Mitokongdrya/SAMI_Presentation/docs/README.md

# Social Animated Mechanical Interlocutor (SAMI) Robot Overview and Documentation
The Social Animated Mechanical Interlocutor (SAMI) robot is made up of several pieces. The physical robot itself, a high-level controlling computer or microcontroller, and the sensor and interaction interface box.

## What is SAMI?

## High Level System Capabilities
