Mitokongdrya/SAMI_Presentation/docs/res/Chest_Back.jpeg

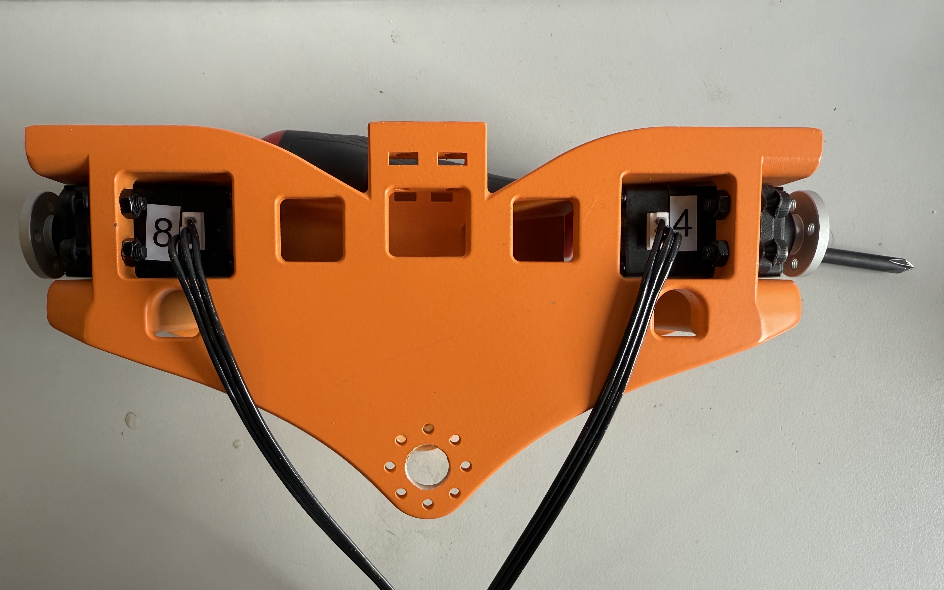
docs/res/Chest_Back.jpeg
