Mitokongdrya/SAMI_Presentation/docs/res/ChestConnector_Angled2.jpeg

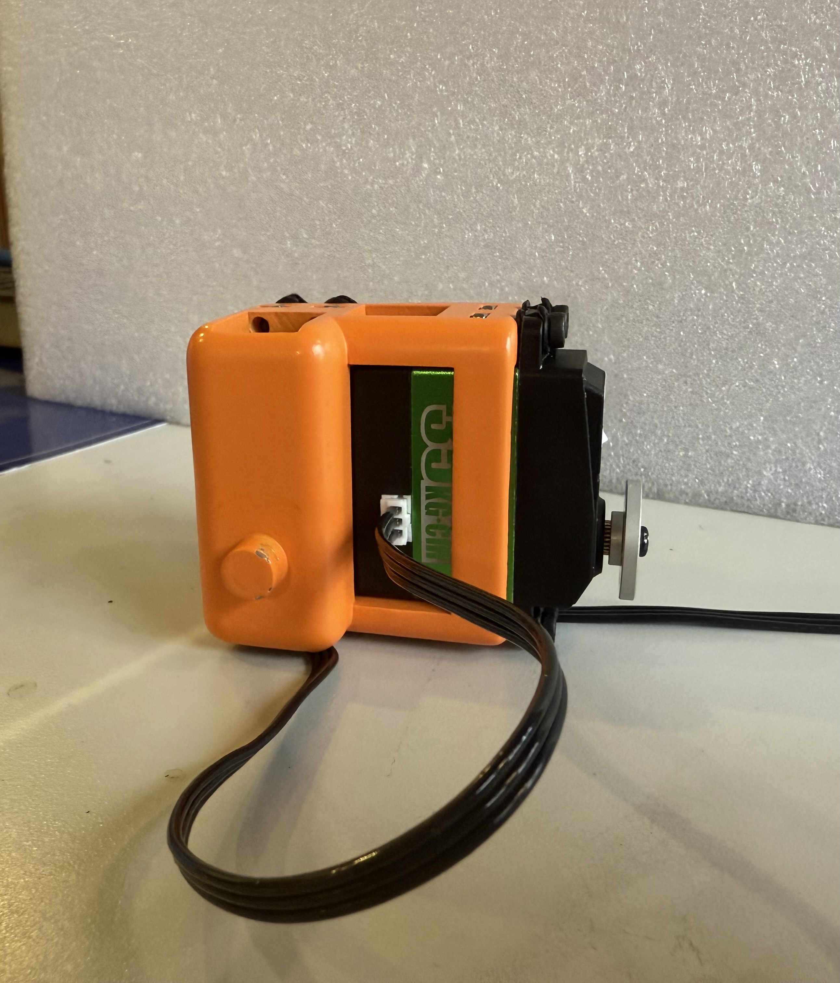
docs/res/ChestConnector_Angled2.jpeg
