Mitokongdrya/SAMI_Presentation/docs/res/ChestConnector_Angled.jpeg

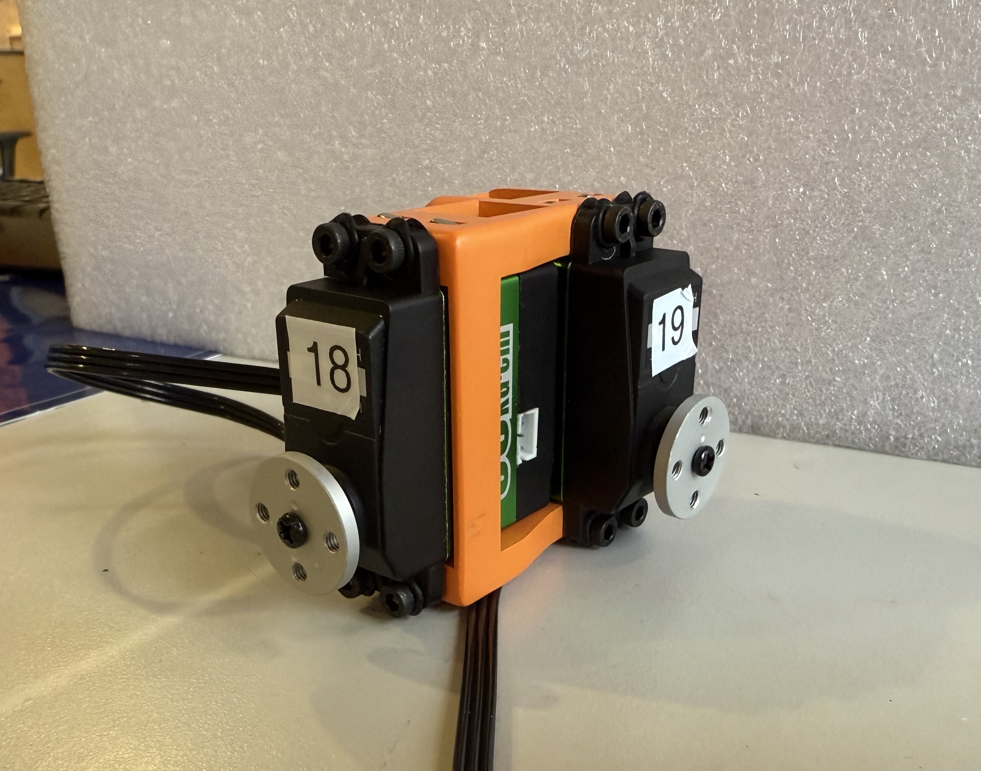
docs/res/ChestConnector_Angled.jpeg
