Mitokongdrya/SAMI_Presentation/docs/res/ChestConnector_Bottom.jpeg

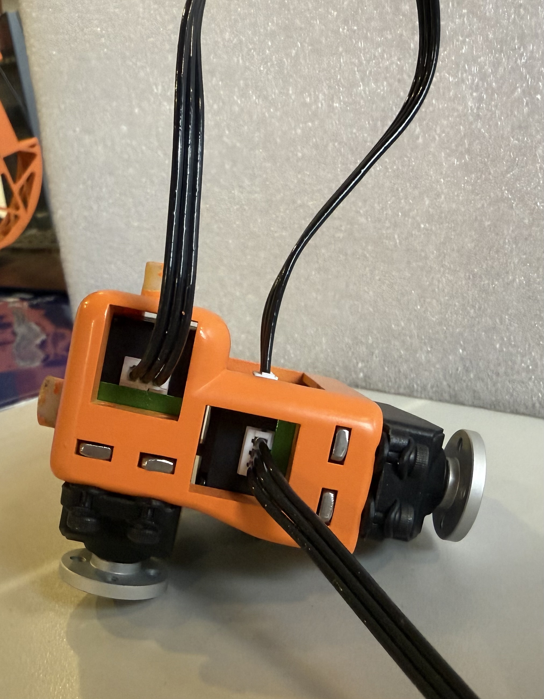
docs/res/ChestConnector_Bottom.jpeg
