Mitokongdrya/SAMI_Presentation/docs/res/Control_Board.jpeg

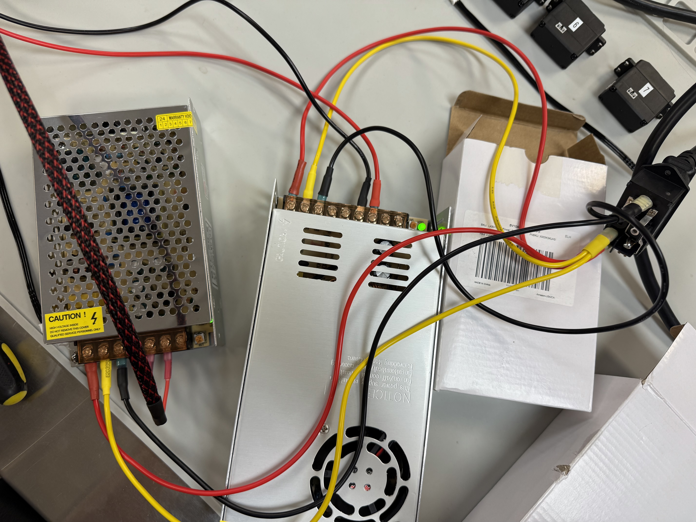
docs/res/Control_Board.jpeg
