Mitokongdrya/SAMI_Presentation/docs/res/LeftFoot_Angled.jpeg

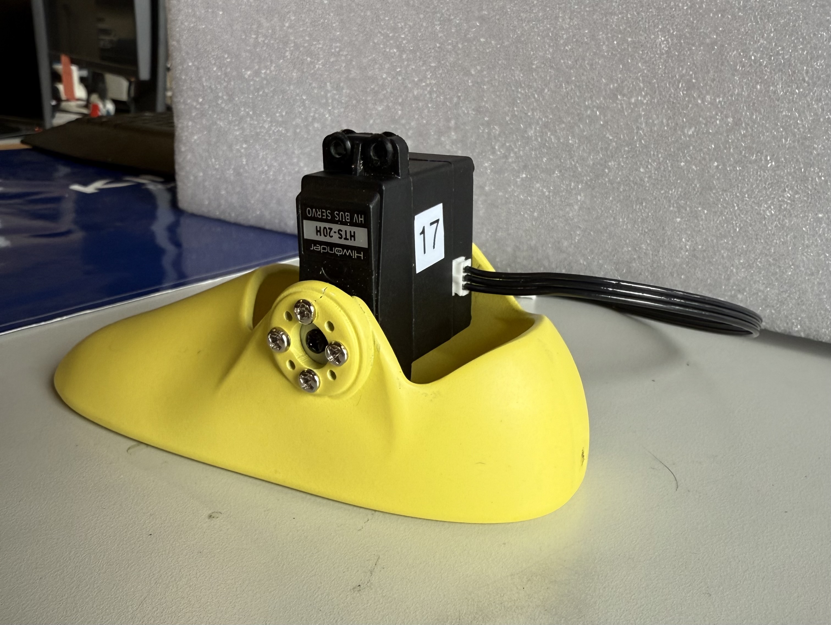
docs/res/LeftFoot_Angled.jpeg
