Mitokongdrya/SAMI_Presentation/docs/res/LeftFoot_Front.jpeg

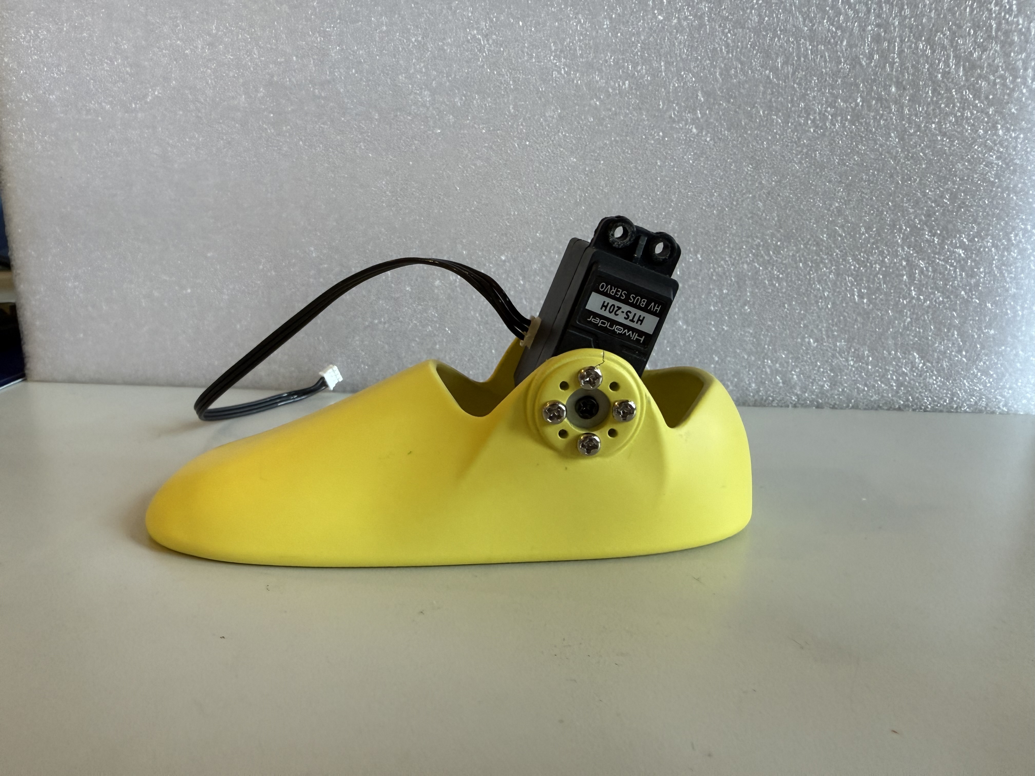
docs/res/LeftFoot_Front.jpeg
