Mitokongdrya/SAMI_Presentation/docs/res/leg_extensions.jpg

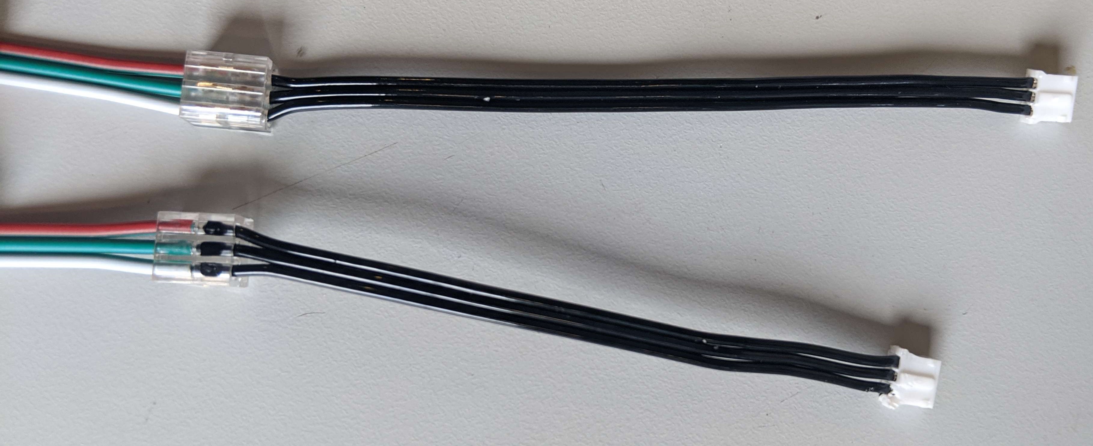
docs/res/leg_extensions.jpg
