Mitokongdrya/SAMI_Presentation/docs/res/long_eyes_conn.jpg

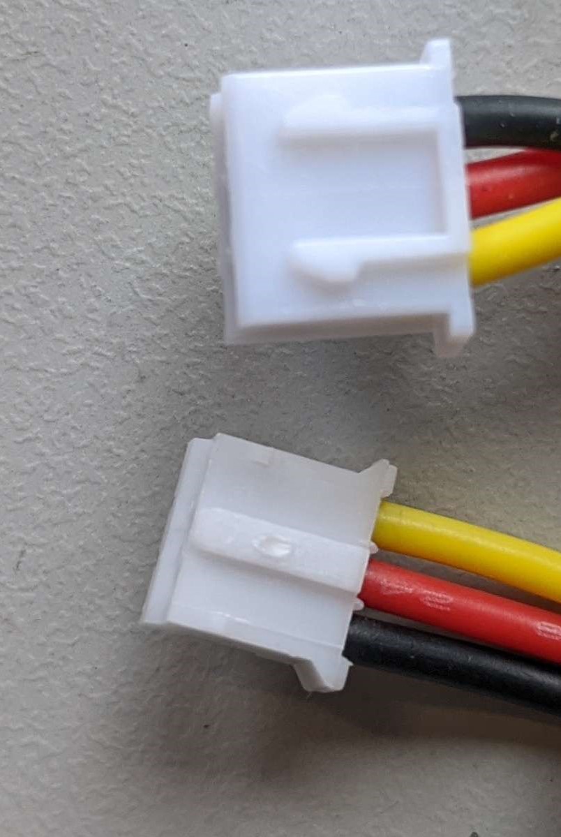
docs/res/long_eyes_conn.jpg
