Mitokongdrya/SAMI_Presentation/docs/res/Neck_Back.jpeg

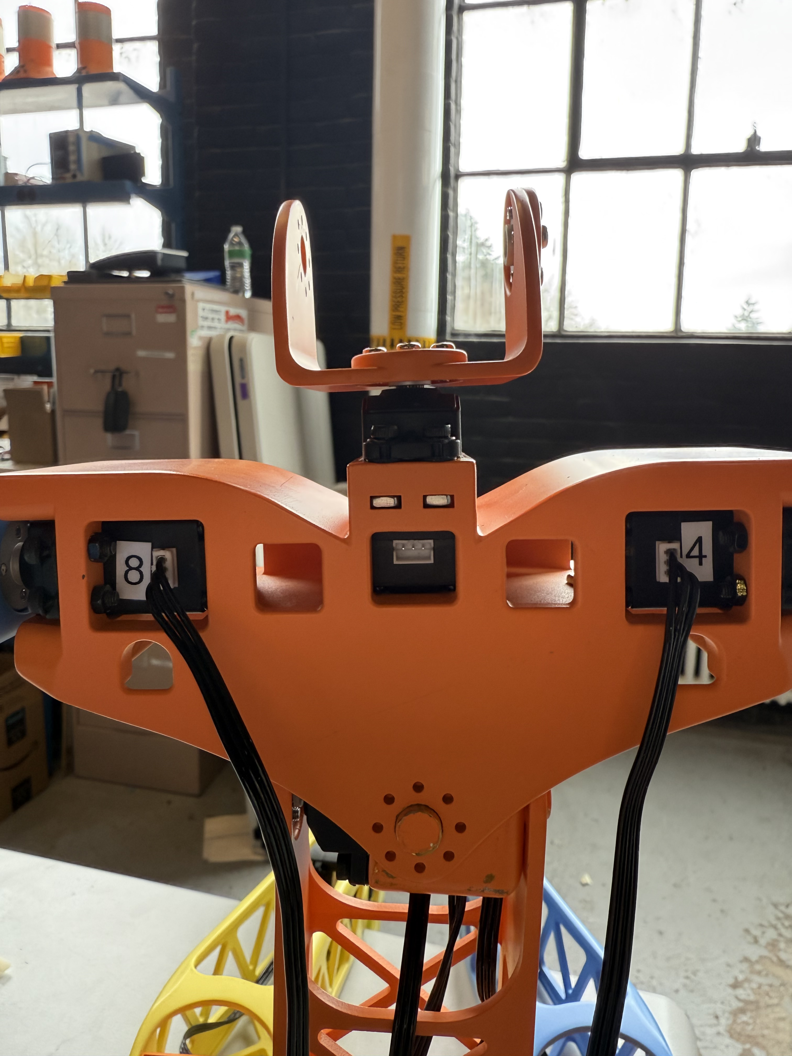
docs/res/Neck_Back.jpeg
