Mitokongdrya/SAMI_Presentation/docs/res/NeckConnector_Angled.jpeg

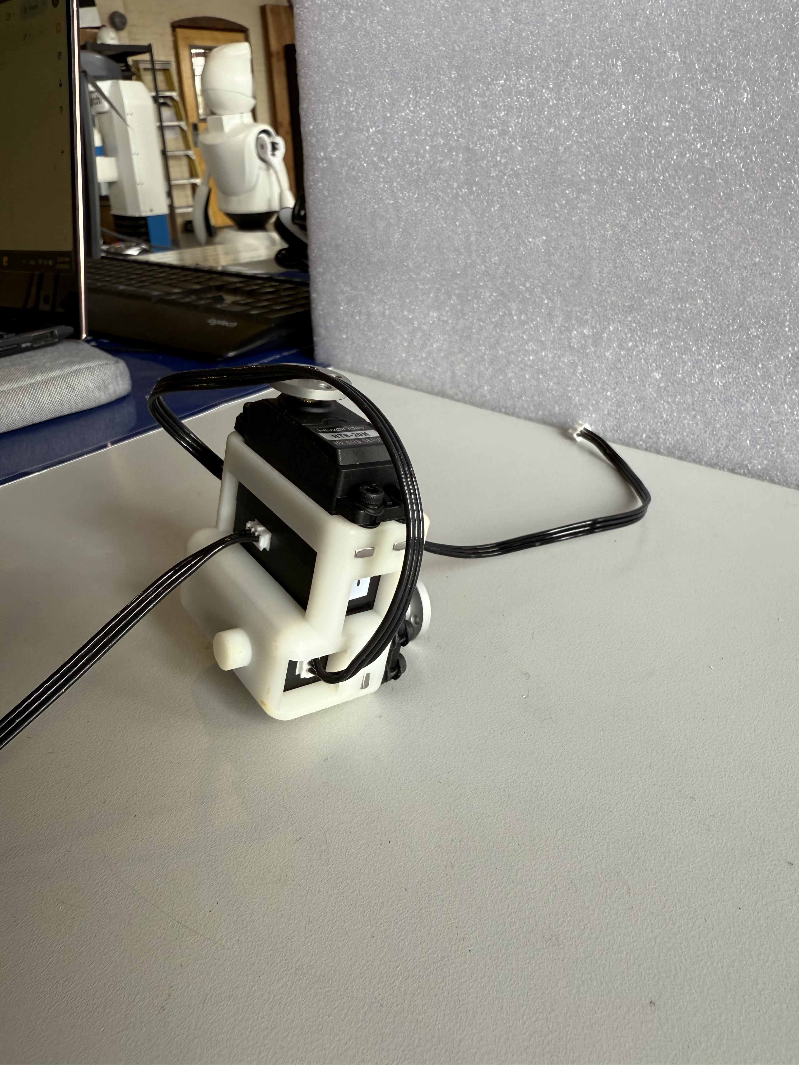
docs/res/NeckConnector_Angled.jpeg
