Mitokongdrya/SAMI_Presentation/docs/res/NeckConnector_Side.jpeg

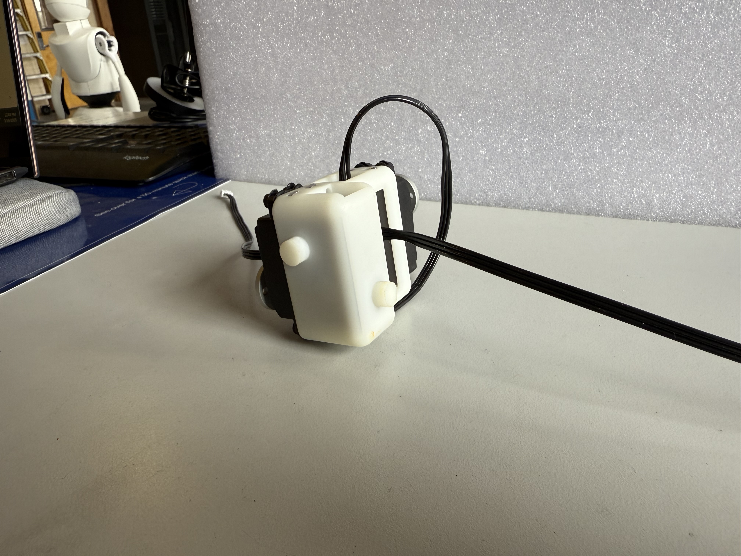
docs/res/NeckConnector_Side.jpeg
