Mitokongdrya/SAMI_Presentation/docs/res/NeckConnector_Top.jpeg

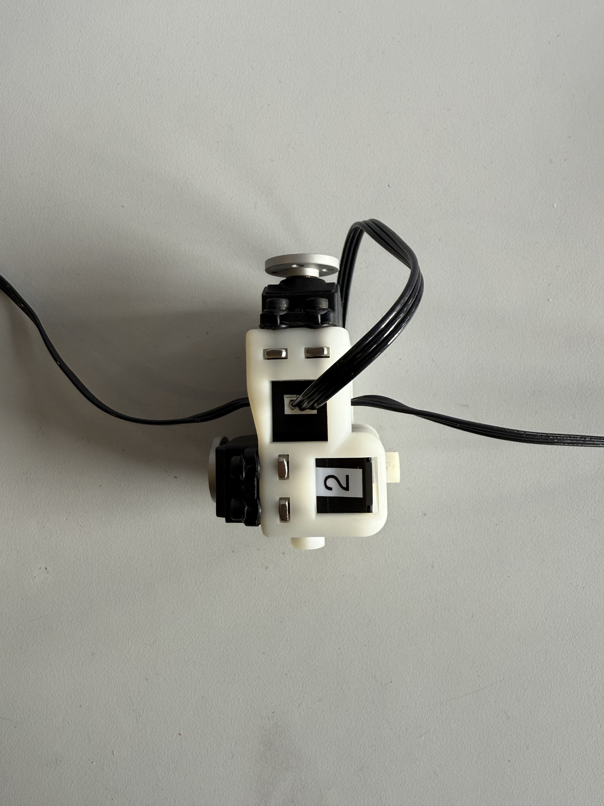
docs/res/NeckConnector_Top.jpeg
