Mitokongdrya/SAMI_Presentation/docs/res/RightLeg_Back.jpeg

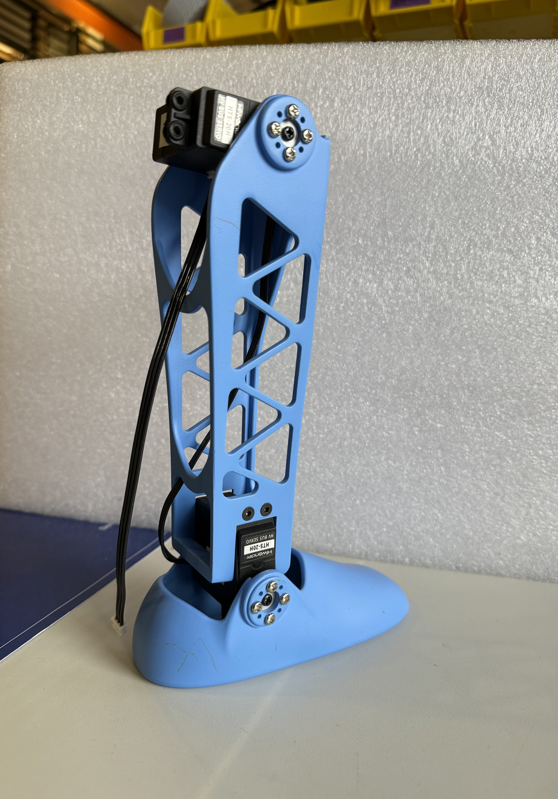
docs/res/RightLeg_Back.jpeg
