Mitokongdrya/SAMI_Presentation/docs/res/short_eyes_conn.jpg

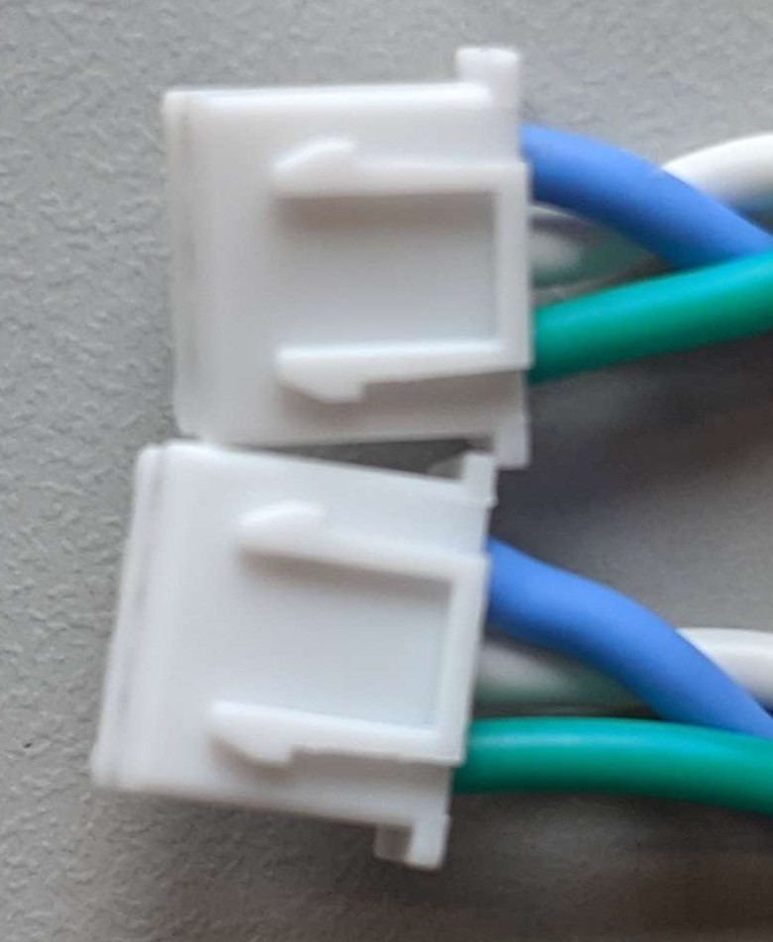
docs/res/short_eyes_conn.jpg
