Mitokongdrya/SAMI_Presentation/docs/res/Shoulder_Bicep_Front.jpeg

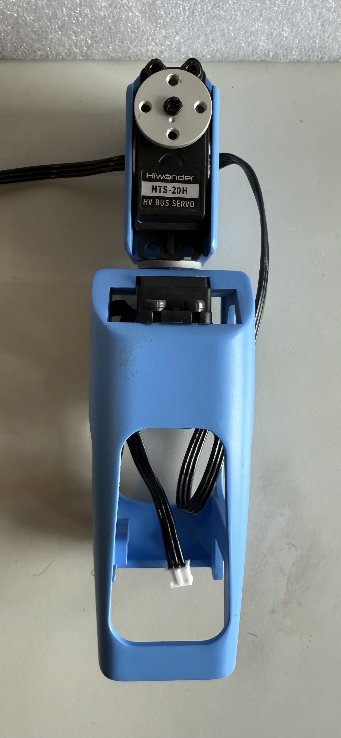
docs/res/Shoulder_Bicep_Front.jpeg
