Mitokongdrya/SAMI_Presentation/docs/res/Shoulder_Bicep_Side.jpeg

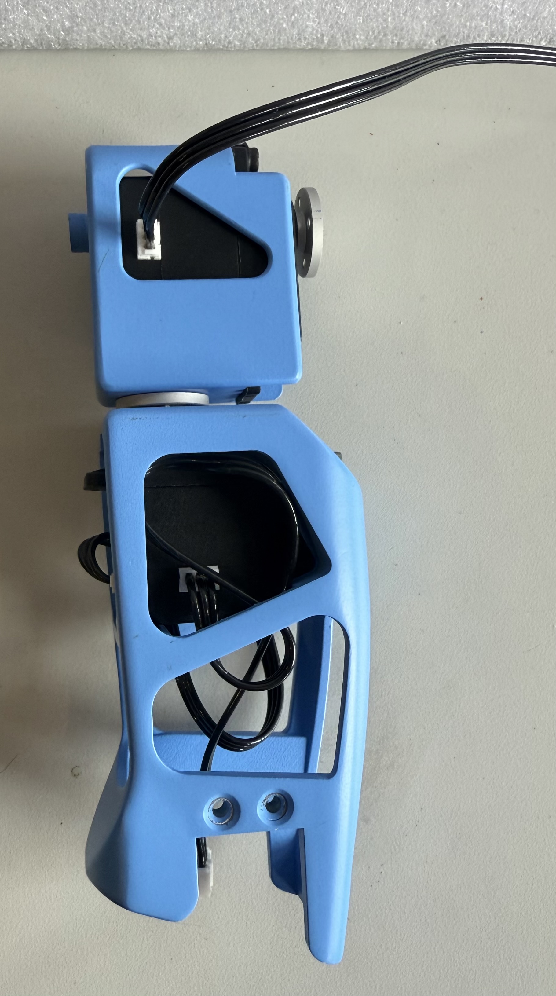
docs/res/Shoulder_Bicep_Side.jpeg
