Mitokongdrya/SAMI_Presentation/hardware/Electrical/res/ArmCurrentRatings.png

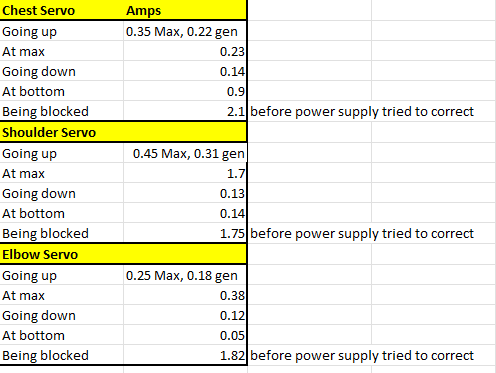
hardware/Electrical/res/ArmCurrentRatings.png
