Mitokongdrya/SAMI_Presentation/hardware/Electrical/res/LegCurrentRatings.png

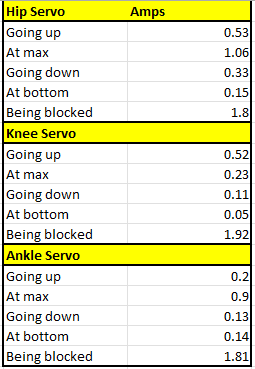
hardware/Electrical/res/LegCurrentRatings.png
