Mitokongdrya/SAMI_Presentation/hardware/SAMIPartList.xlsx

Sheet: Mechanical + Motors
 |  |  | Single Motor |  |  |  |  | Left and Right Side Motor
Part | Quantity | Notes | Head Twist | Head Nod | Head Tilt | Torso Tilt | Torso Bow | Shoulder Pitch | Shoulder Roll | Arm Twist | Elbow | Gripper | Hip | Knee | Ankle | LED Eye | Camera pan
M3x14 countersunk | 4 |  |  |  |  |  |  |  |  |  |  |  |  |  | 2
M3x16 countersunk | 4 |  |  |  |  |  |  |  |  |  | 2
M3x16 | 12 |  |  |  |  |  |  | 4 |  |  |  |  | 2
M3x18 countersunk | 4 |  |  |  |  |  |  |  |  |  |  |  |  | 2
M3x18 | 10 |  | 2 | 2 | 2 | 2 | 2
M3x30 | 4 |  |  |  |  |  |  |  |  | 2
M3x35 | 4 |  |  |  |  |  |  |  | 2
M3x40 | 4 |  |  |  |  |  |  |  |  | 2
M3 hex nut | 28 |  |  |  |  |  |  | 4 | 2 | 2 | 2 |  |  | 2 | 2
M3 square nut | 18 | Fits the 2.6mm x 5.5mm x 5.5mm square nuts | 2 | 2 | 2 | 2 | 2 |  |  | 2 |  |  | 2
M2x6 self-tapping pan head w/ washer | 20 | We could probably use these anywhere we use the M1.6 screws, but we do need them for the ankle | 2 | 2 | 2 |  |  |  |  |  |  |  | 4 |  | 3
M2x8 self-tapping pan head w/ washer | 8 | Specifically for the arm twist, and if we do all self-tapping, we'd use these for the shoulder pitch too |  |  |  |  |  |  |  | 4
M1.6x6 | 36 |  |  |  |  | 4 | 4 |  | 4 |  | 4 |  |  | 4 |  | 2
M1.6x8 | 8 | motor horn |  |  |  |  |  | 4
M1.6 hex nut | 52 | motor horn |  |  |  | 4 | 4 | 4 | 4 |  | 4 |  |  | 4 | 4 | 2
M1.6 flat washer | 52 | motor horn |  |  |  | 4 | 4 | 4 | 4 |  | 4 |  |  | 4 | 4 | 2
HTS-20H | 18 | main servo motor, using the towerpro dimensions | 1 | 1 | 1 |  |  | 1 | 1 | 1 | 1 |  | 1 | 1 | 1 |  | 1
HTS-35H | 2 | Hiwonder servo motor dimensions |  |  |  | 1 | 1
Actuonix PQ12-R-63 | 2 |  |  |  |  |  |  |  |  |  |  | 1

Sheet: Electrical - Non Digikey
Link | Part | Quantity | Type | Notes
 | Microcontroller | 1 | microcontroller | Currently we can run either 3v or 5v logic for the microcontroller, but we require one that has at least 2 uarts and 2 pwm pins
 |  | 1 |  | 12VDC 70A power supply
 |  | 1 |  | 5VDC 4A power supply
 | XT60PW-M | 1 | connector | pcb side power connector
 | XT60P-F | 1 | connector | Power supply connector to pcb

Sheet: DigiKey Robot PartList
Country of Origin may be different at time of shipment.
The HTSUS and ECCN information shown is for informational purposes only and is not a representation or warranty as to the accuracy or reliability of these classifications. All information is provided "as is" and is subject to change without notice. Any use made of the information provided is without recourse to Digi-Key and at the user's risk.
Index | Manufacturer Part Number | Manufacturer Name | Description | Availability | Stock Status | Attrition % | Requested Quantity 1 | Pack Quantity 1 | Pack Type 1 | Digi-Key Part Number 1 | Unit Price 1 | Extended Price 1 | Minimum Order Quantity 1 | Customer Reference | Requested Part Number | Lead Weeks | Datasheet | Reference Designator | US Import Tariff | Note | Part Status | RoHS Status | Moisture Sensitivity Level (MSL) | ECCN | HTSUS | Country of Origin | Environmental Information | Original Part numbers | Image | Product Notes
1 | 1487 | Adafruit Industries LLC | ADDRESS LED MATRIX SERIAL RGB | 27 | In Stock |  | 2 | 2 | Bulk | 1528-1094-ND | 34.95000 | $69.90 | 1 |  | 1528-1094-ND | 6 | https://mm.digikey.com/Volume0/opasdata/d220001/medias/docus/5389/1487_Web.pdf |  | N/A |  | Active | ROHS3 Compliant | 1 (Unlimited) | EAR99 | 8541.41.0000 | United States |  | 1528-1094-ND | https://mm.digikey.com/Volume0/opasdata/d220001/medias/images/2115/1487.JPG
2 | 4301.1405 | SCHURTER Inc. | FUSE DRWR FOR PWR MOD F'GRIP 1PL | 2,346 | In Stock |  | 1 | 1 | Bulk | 486-1956-ND | 3.26000 | $3.26 | 1 |  | 486-1956-ND | 10 | https://www.schurter.com/en/datasheet/typ_Fusedrawer_2.pdf |  | N/A |  | Active | ROHS3 Compliant | Not Applicable | EAR99 | 8538.90.8180 | Czech Republic | https://dam.schurter.com/m/02936985612c49ed/original/Declaration-of-RoHS-Conformance.pdf|https://us.schurter.com/content/download/5693416/86091318/file/REACH%20EN%202021_10_27.pdf | 486-1956-ND | https://mm.digikey.com/Volume0/opasdata/d220001/medias/images/524/4301.1405.JPG
3 | DD11.0113.1110 | SCHURTER Inc. | PWR ENT MOD RCPT IEC320-C14 PNL | 1,155 | In Stock |  | 1 | 1 | Box | 486-1277-ND | 10.71000 | $10.71 | 1 |  | 486-1277-ND | 9 | https://us.schurter.com/en/datasheet/typ_DD11.pdf |  | N/A |  | Active | ROHS3 Compliant | Not Applicable | EAR99 | 8536.69.4030 | Czech Republic | https://dam.schurter.com/m/02936985612c49ed/original/Declaration-of-RoHS-Conformance.pdf|https://us.schurter.com/content/download/5693416/86091318/file/REACH%20EN%202021_10_27.pdf | 486-1277-ND | https://mm.digikey.com/Volume0/opasdata/d220001/medias/images/414/DD11.0113.1110.JPG
4 | BK/GMA-6-R | Eaton - Electronics Division | FUSE GLASS 6A 125VAC 5X20MM | 2,595 | In Stock |  | 1 | 1 | Bulk | 283-2885-ND | 0.69000 | $0.69 | 1 |  | 283-2885-ND | 13 | https://www.eaton.com/content/dam/eaton/products/electronic-components/resources/data-sheet/eaton-gma-time-delay-glass-tube-fuses-data-sheet.pdf |  | May apply on shipments to the U.S. |  | Active | ROHS3 Compliant | 1 (Unlimited) | EAR99 | 8536.10.0020 | China |  | 283-2885-ND | https://mm.digikey.com/Volume0/opasdata/d220001/medias/images/1063/CooperBussmann-SERIES-GMA.jpg
5 | PR24-5V-900-1A | CUI Devices | RELAY GEN PURPOSE SPST 40A 5V | 908 | In Stock |  | 3 | 3 | Tray | 2223-PR24-5V-900-1A-ND | 1.65000 | $4.95 | 1 |  | 2223-PR24-5V-900-1A-ND | 10 | https://www.cuidevices.com/product/resource/digikeypdf/pr24.pdf |  | May apply on shipments to the U.S. |  | Active | ROHS3 Compliant | Not Applicable | EAR99 | 8536.41.0050 | China |  | 2223-PR24-5V-900-1A-ND | https://mm.digikey.com/Volume0/opasdata/d220001/medias/images/4502/MFG_PR24-5V-900-1A.jpg
6 | 40SQ045 | ANBON SEMICONDUCTOR (INT'L) LIMITED | 40A AXIAL LEADED SCHOTTKY DIODES | 206 | In Stock |  | 3 | 3 | Cut Tape (CT) | 4530-40SQ045CT-ND | 1.29000 | $3.87 | 1 |  | 4530-40SQ045CT-ND | 4 | https://mm.digikey.com/Volume0/opasdata/d220001/medias/docus/4890/40SQ045.pdf |  | N/A |  | Active | ROHS3 Compliant | 1 (Unlimited) | EAR99 | 8541.10.0080 | China |  | 4530-40SQ045CT-ND | https://mm.digikey.com/Volume0/opasdata/d220001/medias/images/4887/MFG_40SQ045.jpg
7 | 1N4732A | onsemi | DIODE ZENER 4.7V 1W DO41 | 10,195 | In Stock |  | 3 | 3 | Bulk | 1N4732AFS-ND | 0.24000 | $0.72 | 1 |  | 1N4732AFS-ND | 32 | https://rocelec.widen.net/view/pdf/7qfz7dzkx8/ONSM-S-A0003585147-1.pdf?t.download=true&u=5oefqw |  | May apply on shipments to the U.S. |  | Active | ROHS3 Compliant | Not Applicable | EAR99 | 8541.10.0050 | China | https://www.onsemi.com/site/pdf/RoHS-statement.pdf|https://www.onsemi.com/PowerSolutions/MaterialComposition.do?export=pdf&opnId=1N4732A | 1N4732AFS-ND | https://mm.digikey.com/Volume0/opasdata/d220001/medias/images/1177/DO-204AL.jpg
8 | 1N4001-G | Comchip Technology | DIODE GEN PURP 50V 1A DO41 | 38,214 | In Stock |  | 3 | 3 | Cut Tape (CT) | 641-1310-1-ND | 0.21000 | $0.63 | 1 |  | 641-1310-1-ND | 10 | https://www.comchiptech.com/admin/files/product/1N4001-G%20Thru.%201N4007-G%20RevB.pdf |  | N/A |  | Active | ROHS3 Compliant | 1 (Unlimited) | EAR99 | 8541.10.0080 | Taiwan | https://www.comchiptech.com/admin/files/tech/213_20201006093628.pdf | 641-1310-1-ND | https://mm.digikey.com/Volume0/opasdata/d220001/medias/images/4849/641_1N5819-G.JPG
9 | BC337-25 | Diotec Semiconductor | BJT TO-92 45V 800MA | 10,501 | In Stock |  | 3 | 3 | Cut Tape (CT) | 4878-BC337-25CT-ND | 0.18000 | $0.54 | 1 |  | 4878-BC337-25CT-ND | 2 | https://diotec.com/request/datasheet/bc337.pdf |  | May apply on shipments to the U.S. |  | Active | Not applicable | Not Applicable | EAR99 | 8541.21.0075 | China | https://diotec.com/request/imds/p210_e.pdf | 4878-BC337-25CT-ND | https://mm.digikey.com/Volume0/opasdata/d220001/medias/images/3602/MFG_BC327-16.jpg
10 | R-78E5.0-1.0 | Recom Power | DC DC CONVERTER 5V 5W | 1,854 | In Stock |  | 2 | 2 | Tube | 945-2201-ND | 3.92000 | $7.84 | 1 |  | 945-2201-ND | 4 | https://recom-power.com/pdf/Innoline/R-78E-1.0.pdf |  | May apply on shipments to the U.S. |  | Active | ROHS3 Compliant | 1 (Unlimited) | EAR99 | 8542.39.0060 | Taiwan | https://recom-power.com/en/support/certifications/rohs/rohs.html?0 | 945-2201-ND | https://mm.digikey.com/Volume0/opasdata/d220001/derivates/6/002/665/033/MFG_R-78-e%20series_web%28640x640%29.jpg
11 | EY1C102MP51016EU | Chinsan (Elite) | CAP ALUM 1000UF 20% 16V RADIAL | 280 | In Stock |  | 1 | 1 | Cut Tape (CT) | 4191-EY1C102MP51016EUCT-ND | 0.33000 | $0.33 | 1 |  | 4191-EY1C102MP51016EUCT-ND | 18 | https://mm.digikey.com/Volume0/opasdata/d220001/medias/docus/2526/EY%20Series.pdf |  | N/A |  | Active | ROHS3 Compliant | 1 (Unlimited) | EAR99 | 8532.22.0020 | China |  | 4191-EY1C102MP51016EUCT-ND | https://mm.digikey.com/Volume0/opasdata/d220001/medias/images/4520/MFG_Radial-lead-type-brown.jpg | Non Cancellable Non Returnable.
12 | SN74HC126N | Texas Instruments | IC BUFFER NON-INVERT 6V 14DIP | 2,195 | In Stock |  | 1 | 1 | Tube | 296-8221-5-ND | 0.69000 | $0.69 | 1 |  | 296-8221-5-ND | 12 | https://www.ti.com/lit/ds/symlink/sn74hc126.pdf |  | N/A |  | Active | ROHS3 Compliant | Not Applicable | EAR99 | 8542.39.0060 | Malaysia |  | 296-8221-5-ND | https://mm.digikey.com/Volume0/opasdata/d220001/medias/images/3623/Mfg_296%7E4040049%7EN%7E14.jpg
13 | LR1F1K0 | TE Connectivity Passive Product | RES 1K OHM 1% 0.6W AXIAL | 579,931 | In Stock |  | 2 | 2 | Cut Tape (CT) | A105951CT-ND | 0.10000 | $0.20 | 1 |  | A105951CT-ND | 14 | https://www.te.com/usa-en/product-1622349-1.datasheet.pdf |  | N/A |  | Active | ROHS3 Compliant | Not Applicable | EAR99 | 8533.21.0090 | Thailand | http://www.te.com/commerce/alt/SinglePartSearch.do?PN=1622349-1&dest=stmt | A105951CT-ND | https://mm.digikey.com/Volume0/opasdata/d220001/medias/images/2609/LR%20Neohm%201k.jpg
14 | LR1F10K | TE Connectivity Passive Product | RES 10K OHM 1% 0.6W AXIAL | 803,334 | In Stock |  | 1 | 1 | Cut Tape (CT) | A105947CT-ND | 0.10000 | $0.10 | 1 |  | A105947CT-ND | 14 | https://www.te.com/usa-en/product-1622298-1.datasheet.pdf |  | N/A |  | Active | ROHS3 Compliant | Not Applicable | EAR99 | 8533.21.0090 | Thailand | http://www.te.com/commerce/alt/SinglePartSearch.do?PN=1622298-1&dest=stmt | A105947CT-ND | https://mm.digikey.com/Volume0/opasdata/d220001/medias/images/2584/LR%20Neohm%2010k.jpg
15 | 2N3904 | Diotec Semiconductor | BJT TO-92 40V 200MA | 1,944 | In Stock |  | 1 | 1 | Cut Tape (CT) | 4878-2N3904CT-ND | 0.13000 | $0.13 | 1 |  | 4878-2N3904CT-ND | 2 | https://diotec.com/request/datasheet/2n3904.pdf |  | May apply on shipments to the U.S. |  | Active | Not applicable | Not Applicable | EAR99 | 8541.21.0075 | China | https://diotec.com/request/imds/p210_e.pdf | 4878-2N3904CT-ND | https://mm.digikey.com/Volume0/opasdata/d220001/medias/images/3602/MFG_BC327-16.jpg
16 | FG26X7R1E106KRT06 | TDK Corporation | CAP CER 10UF 25V X7R RADIAL | 14,216 | In Stock |  | 4 | 4 | Cut Tape (CT) | 445-173437-1-ND | 0.68000 | $2.72 | 1 |  | 445-173437-1-ND | 24 | https://product.tdk.com/en/system/files |  | May apply on shipments to the U.S. |  | Active | ROHS3 Compliant | Not Applicable | EAR99 | 8532.24.0060 | China | https://product.tdk.com/en/environment/index.html | 445-173437-1-ND | https://mm.digikey.com/Volume0/opasdata/d220001/medias/images/21/MFG_FG26.JPG
