Mitokongdrya/SAMI_Presentation/hardware/Electrical/SensorArduinoHat/CD74HC14E/N0014A.stp

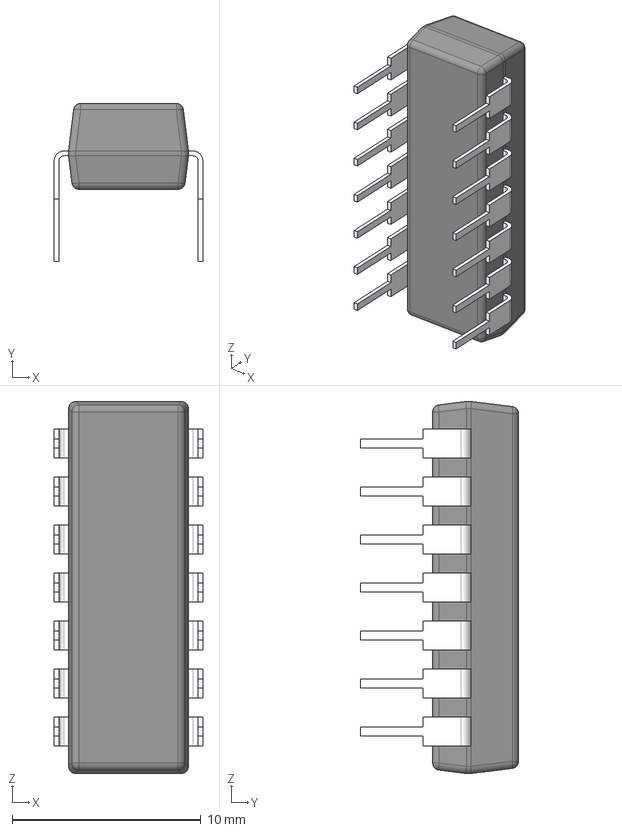
[picture p27: CAD file, 2026-03-08]
hardware/Electrical/SensorArduinoHat/CD74HC14E/N0014A.stp
7.87 x 8.37 x 19.7 mm
BODY_N0014A_AF0
LEAD_N0014A_AF1
LEAD_N0014A x 10
LEAD_N0014A_AF3
LEAD_N0014A_AF0
LEAD_N0014A_AF2
