Mitokongdrya/SAMI_Presentation/docs/component-fabrication.md

---
layout: default
id: part-fabrication
title: Sub-Assembly Fabrication for the Robot
sidebar_label: Part Fabrication
previous_page: assembly-intro
next_page: assembly-control
---
# Sub-Assembly Fabrication for the Robot

## 3D Printing & Orientations
*If using Prusa i3 printers with Prusa Slicer,* all parts should be printed at 0.3mm resolution ("draft quality" on Prusa Slicer), with 15% gyroid infill, and organic supports enabled (where necessary), **except for the chest piece,** which should be printed at 0.2mm resolution, with 15% gyroid infill, and normal grid-style supports instead. Alternatively, the **finger hinges** should be printed using TPU filament with 0% gyroid infill and a brim.

**The hands** used for this robot have been sized down by 42.5% with minimal changes to the bolt holes from the [original prosthetic model](), but the mechanism funtionality remains the same.

Print orientations are shown below for each part, along with the part names that are used throughout this documentation.

### Headshell
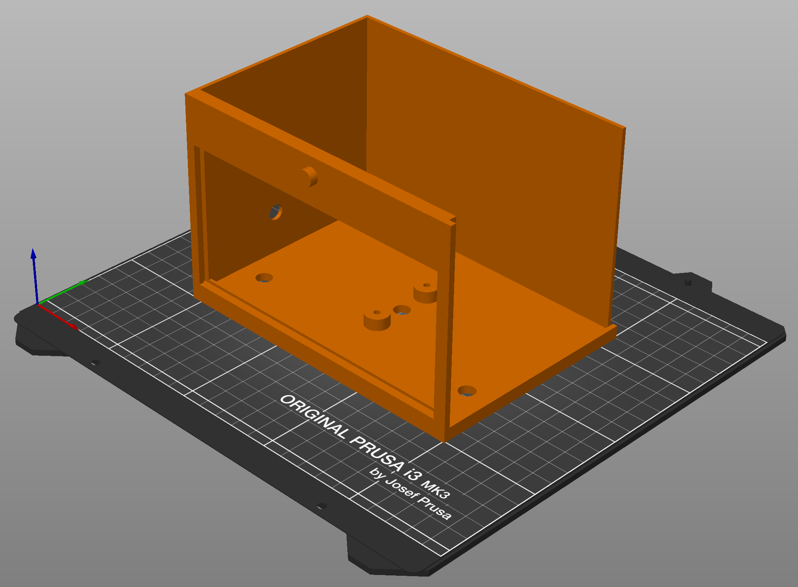
[picture p105: docs/res/Headshell.png]


### Chest and Headshell Panel
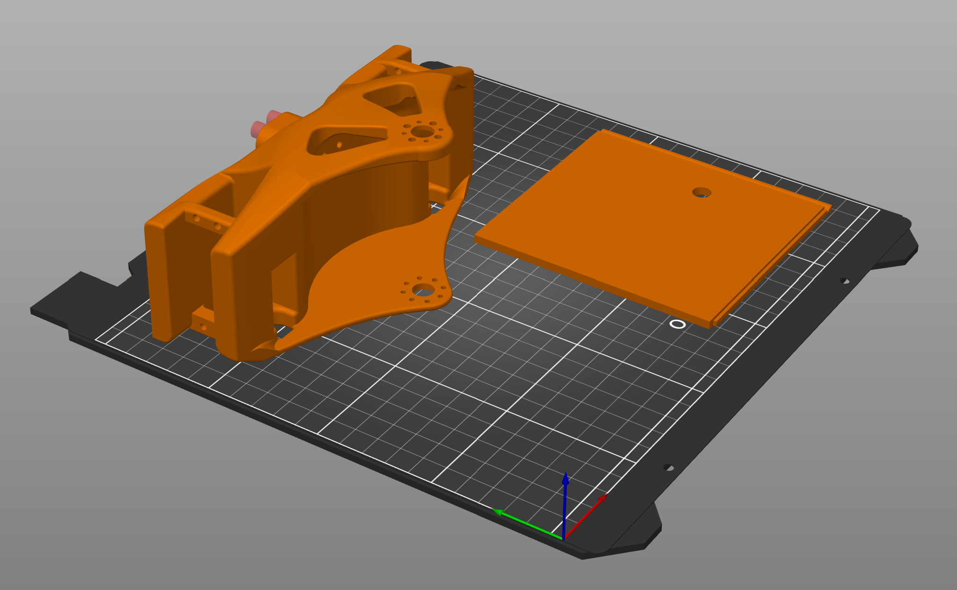
[picture p106: docs/res/Chest_HeadshellSidePanel.png]


### Head/Neck Connectors and Spine
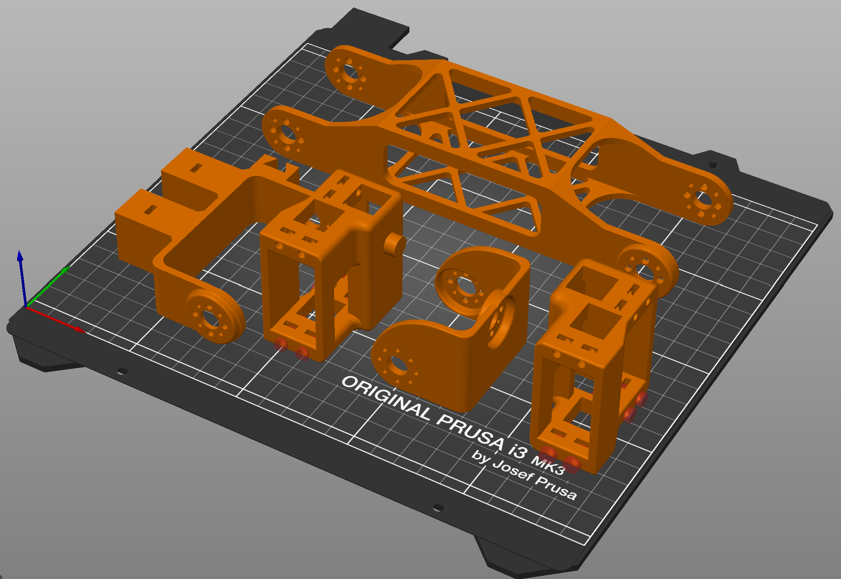
[picture p107: docs/res/HeadnNeck_Connector_Spine.png]


### Shoulders and Upper Arms
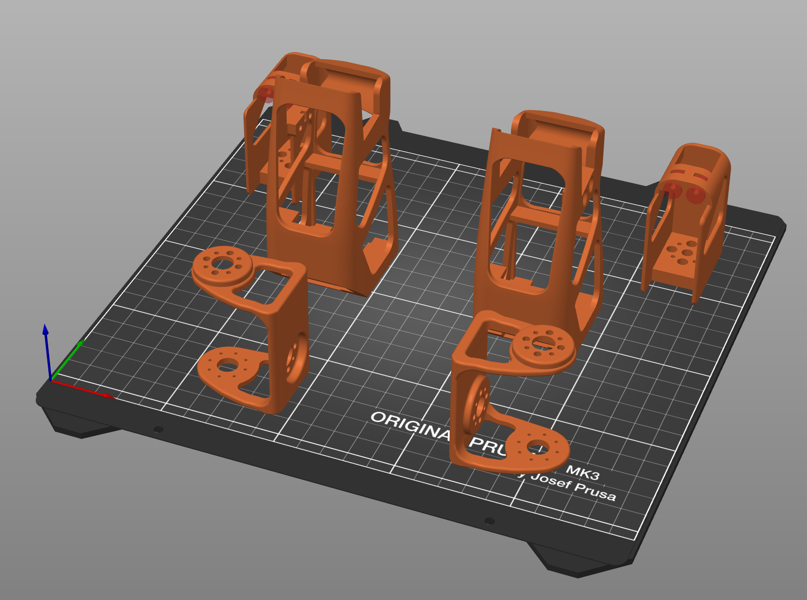
[picture p108: docs/res/Shoulders_Biceps.png]


### Hands and Lower Arms
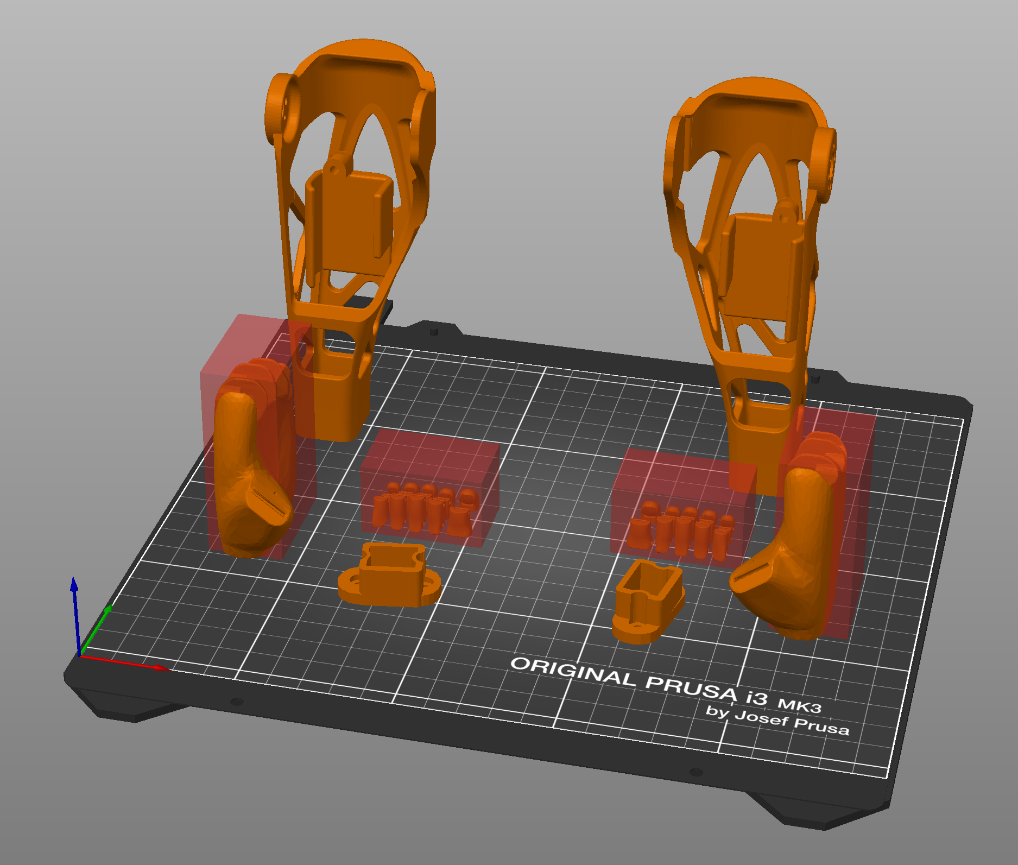
[picture p109: docs/res/Hands_Lower Arms.png]


### Finger Hinges
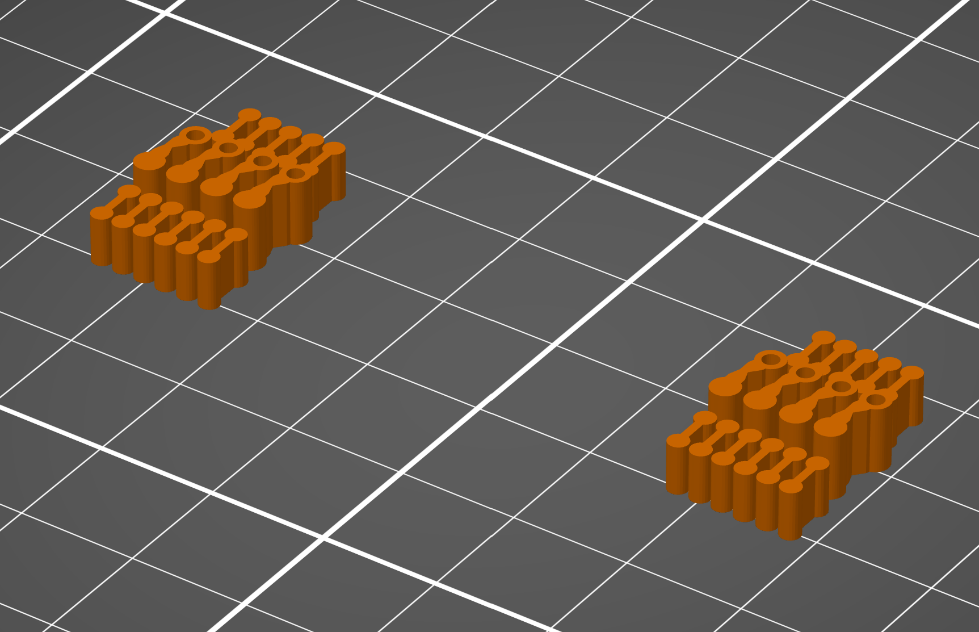
[picture p110: docs/res/FFX_Finger_Hinge_Plate.png]


### Hips and Upper Legs
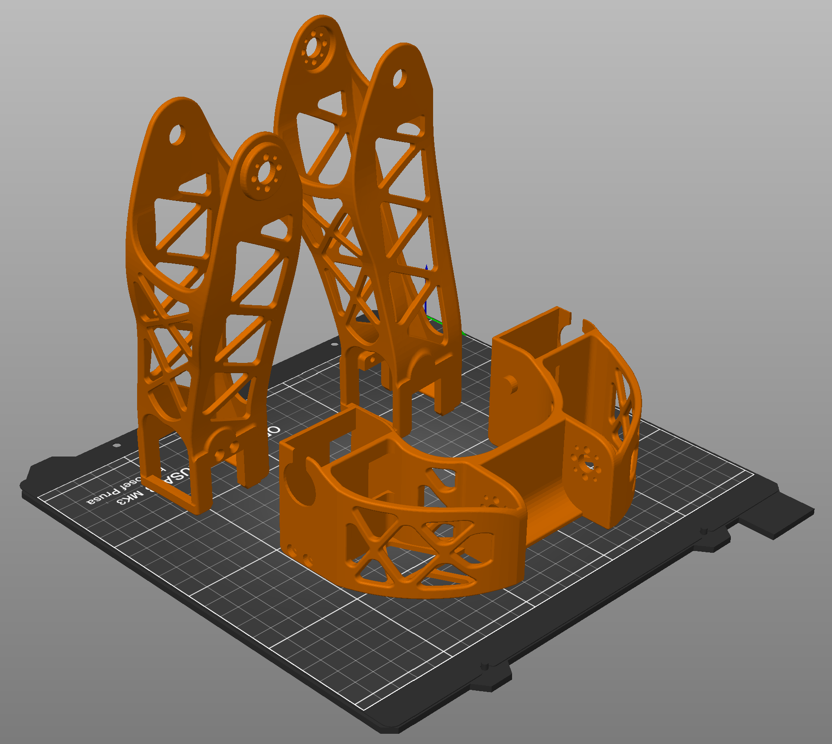
[picture p111: docs/res/Hip_UpperLegs.png]


### Lower Legs and Feet
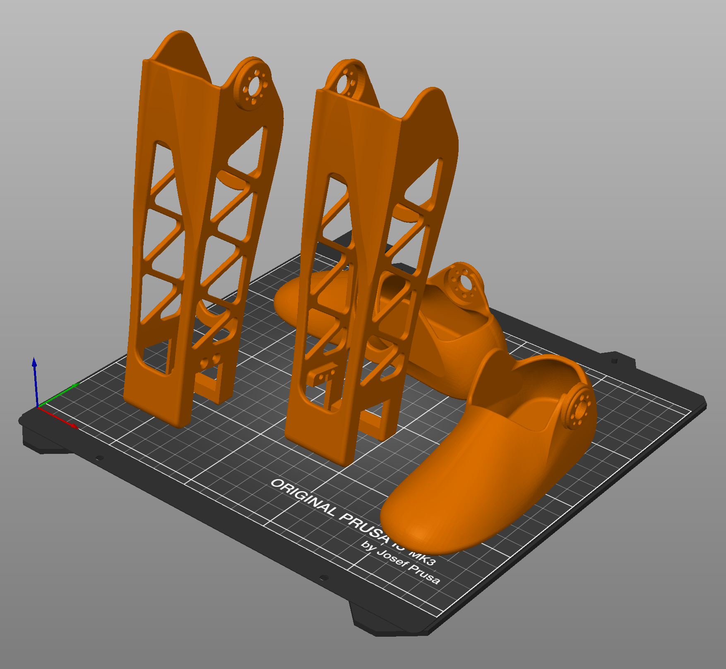
[picture p112: docs/res/LowerLegs_Feet.png]
