Mitokongdrya/SAMI_Presentation/docs/Getting-Started.md

---
layout: default
id: getting-started
title: Getting Started with the System
sidebar_label: Getting Started
next_page: assembly-intro
---
# Getting Started with the System
