Mitokongdrya/SAMI_Presentation/docs/Robot-Assembly.md

---
layout: default
id: robot-assembly
title: Robot Assembly Guide
sidebar_label: Robot Assembly
---
# Robot Assembly Guide
This section describes the part fabrication and hardware assembly process for the actual robot.
1. [3D Printing & Orientations](#3d-printing--orientations)
2. [Setting Up the Control Board](#setting-up-the-control-board)
3. [Initializing Servo IDs and Positions](#initializing-servo-ids-and-positions)
4. [Overall Assembly Information]()
5. [Neck and Torso Assembly](#neck-and-torso-assembly)
6. [Arm Assembly](#arm-assembly)
7. [Lower Body Assembly](#lower-body-assembly)
8. [Chair Assembly](#chair-modification-and-assembly)
9. [Final Assembly](#final-assembly)

The layout of the parts for the robot, with names that are used within these instructions.



## 3D Printing & Orientations
*If using Prusa i3 printers with Prusa Slicer,* all parts should be printed at 0.3mm resolution ("draft quality" on Prusa Slicer), with 15% gyroid infill, and organic supports enabled (where necessary), **except for the chest piece,** which should be printed at 0.2mm resolution, with 15% gyroid infill, and normal grid-style supports instead. Alternatively, the **finger hinges** should be printed using PETG filament with 0% gyroid infill and a brim.

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

### Headshell


### Chest and Headshell Panel


### Head/Neck Connectors and Spine


### Shoulders and Upper Arms


### Hands and Lower Arms


### Finger Hinges


### Hips and Upper Legs


### Lower Legs and Feet
   

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

   

7. Plug power cord to switch, then to a nearby power outlet.

Reference image:

   

## Initializing Servo IDs and Positions
You will need to communicate with the motors as part of the assembly process. This process can be completed using the [assembled motor control PCB](#setting-up-the-control-board), or the [HiWonder motor debugging board](https://www.hiwonder.com/products/hiwonder-ttl-usb-debugging-board).

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



To simplify assembly, the initialization steps for each motor are:

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

## Lower Body Assembly
When assembling the lower body it is best to start with the feet and then work your way up to the upper legs. This ensures that you will have everything aligned and allows you to plug to corresponding JST cables as you go.

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

Final product:




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

Reference figures:




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

Final product:



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

Final product, Left Leg:




Final product, Right Leg:

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

Final product:

   
   

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

Left Shoulder Chest

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

With both motors installed and JST cables connected, the chest from behind should look like 

   
    

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


-->

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

Chest Bow

1. Insert the black rubber spacers into all four of the screw slots on motor 19

   
**Use the connector on the right for Chest Assembly.**

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

Chest tilt

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

Attaching to the Chest

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

The figure below shows screw placement:

   
   

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

Final product: 

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

Neck Bow

1. Insert the black rubber spacers into all four of the screw slots on motor 2

   
**Use the connector on the left for Neck Assembly.**

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

Neck Tilt

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

   
   

## Arm Assembly
When assembling the arms for the robot, it is best to begin with the bicep, then shoulder, and ending with the forearms. This is due to the slight complexity behind the arm assembly. You will need to attach the motors and JST cables onto certain pieces before moving on.

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

The forearms will require one Actuonix PQ12 Micro Linear Actuator each. 

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

Bicep references with JST cables:




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

Final products (Right motor and Left motor):




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

Outcome of servo horn attachment:

   
   

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

Final product:

   
   

### Forearms
The Forearms will require:
 - a M3 hex screwdriver
 - 8x silver M3 screws

Pre-thread all screw holes before assembly.

1. Attach Forearms to respective Biceps using 4 silver M3 screws each.

Final assembly (ignore color differences, pieces were printed incorrectly):

   

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



*Figure 2*: Finger plate with labeled orientation ([Flexy-Hand 2](https://www.thingiverse.com/thing:380665))



*Figure 3*: Hinge orientation for all fingers ([Flexy-Hand 2](https://www.thingiverse.com/thing:380665))



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



*Figure 5*: Fisherman's Knot instructional image

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

   

Final product (Right Arm):

   
   

## Chair Modification and Assembly

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

Begin by first assembling the Ikea chair following their instructions.

### Power Switch

Requires:

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

### 12V Supply Mounting

Requires:

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

    

### 5V Supply Mounting

Requires:

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

### Motor Control PCB Mounting

Requires:

 - Ikea chair
 - Motor control PCB assembly
 - M3x??+6 standoffs x4
 - [PCB mounting template]()

### Robot Mounting

Requires:

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

## Final Assembly

### Eyes Assembly

Assembly of the eyes requires:

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

### Connect The Remaining Cables

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

### Flash Arduino Code

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

### Test Motor movements

Test movements for the motors using the software UI
