Mitokongdrya/SAMI_Presentation/docs/software-setup.md

---
layout: default
id: software-setup
title: Initial Software Setup and Testing
sidebar_label: Software Setup
previous_page: assembly-final
next_page: software-architecture
---
# Initial Software Setup and Testing
