Mitokongdrya/SAMI_Presentation/hardware/Electrical/JamieMotorControl/JamieMotorControl.kicad_pcb

## KiCad design hardware/Electrical/JamieMotorControl/JamieMotorControl.kicad_pcb (2026-03-08)

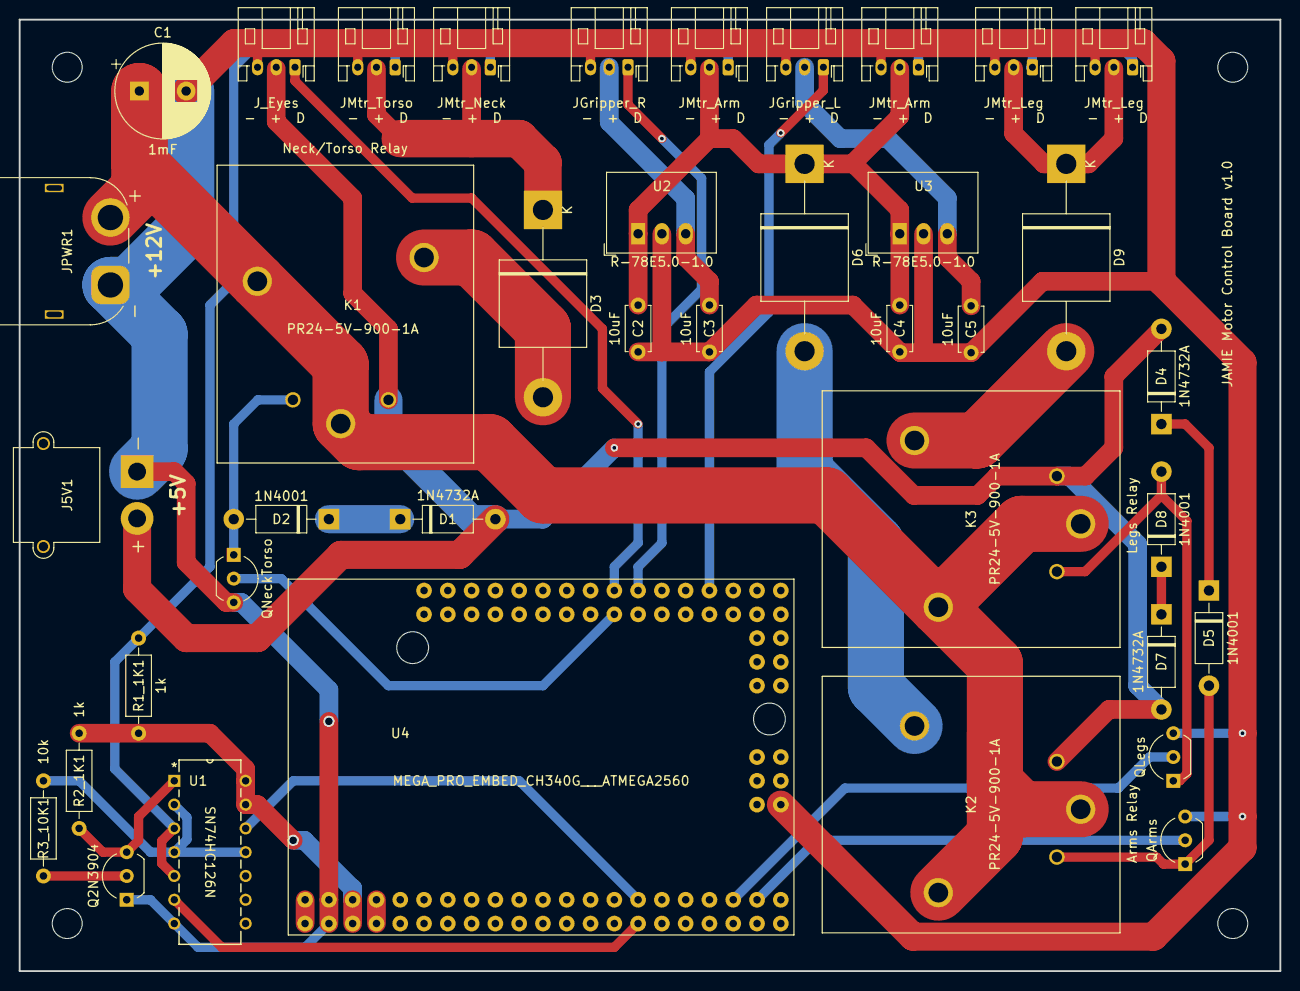
[picture p114: board JamieMotorControl.kicad_pcb from above]

Board: 2 copper layers, 134.6 x 101.6 mm, 43 parts (0 on the bottom side), 32 nets.

Parts:
C1: 1mF; CP_Radial_D10.0mm_P5.00mm
C2, C3, C4, C5: 10uF; C_Disc_D4.7mm_W2.5mm_P5.00mm
D1, D4, D7: 1N4732A; D_DO-41_SOD81_P10.16mm_Horizontal
D2, D5, D8: 1N4001; D_DO-41_SOD81_P10.16mm_Horizontal
D3, D6, D9: 40SQ045; D_P600_R-7_P20.00mm_Horizontal
H1, H2, H3, H4: MountingHole; MountingHole_3.2mm_M3
J5V1: Conn_01x02; AMASS_XT30PW-M_1x02_P2.50mm_Horizontal
JGripper_L: JST01x03_R; JST_PH_S3B-PH-K_1x03_P2.00mm_Horizontal
JGripper_R: JST01x03_R; JST_PH_S3B-PH-K_1x03_P2.00mm_Horizontal
JMtr_Arm: JST01x03_R; JST_PH_S3B-PH-K_1x03_P2.00mm_Horizontal
JMtr_Arm#2: JST01x03_R; JST_PH_S3B-PH-K_1x03_P2.00mm_Horizontal
JMtr_Leg: JST01x03_R; JST_PH_S3B-PH-K_1x03_P2.00mm_Horizontal
JMtr_Leg#2: JST01x03_R; JST_PH_S3B-PH-K_1x03_P2.00mm_Horizontal
JMtr_Neck: JST01x03_R; JST_PH_S3B-PH-K_1x03_P2.00mm_Horizontal
JMtr_Torso: JST01x03_R; JST_PH_S3B-PH-K_1x03_P2.00mm_Horizontal
JPWR1: Conn_01x02; AMASS_XT60PW-M_1x02_P7.20mm_Horizontal
J_Eyes: JST01x03_R; JST_PH_S3B-PH-K_1x03_P2.00mm_Horizontal
K1, K2, K3: PR24-5V-900-1A; RELAY_PR24-5V-900-1A
Q2N3904: 2N3904; TO-92_Inline_Wide
QArms: BC337; TO-92_Inline_Wide
QLegs: BC337; TO-92_Inline_Wide
QNeckTorso: BC337; TO-92_Inline_Wide
R1_1K1, R2_1K1: 1k; R_Axial_DIN0207_L6.3mm_D2.5mm_P10.16mm_Horizontal
R3_10K1: 10k; R_Axial_DIN0207_L6.3mm_D2.5mm_P10.16mm_Horizontal
U1: SN74HC126N; N14
U2, U3: R-78E5.0-1.0; Converter_DCDC_RECOM_R-78E-0.5_THT
U4: MEGA_PRO_EMBED_CH340G___ATMEGA2560; MODULE_MEGA_PRO_EMBED_CH340G___ATMEGA2560

Connections:
5V: D1.2 (A), D4.2 (A), D7.2 (A), J5V1.2, J_Eyes.2, K1.A1, K2.A1, K3.A1
12V: C1.1, JPWR1.2, K1.COM_1, K1.COM_2, K2.COM_1, K2.COM_2, K3.COM_1, K3.COM_2
/MTR_SIG: JMtr_Arm.1, JMtr_Arm#2.1, JMtr_Leg.1, JMtr_Leg#2.1, JMtr_Neck.1, JMtr_Torso.1, R1_1K1.2, U1.3 (1Y), U1.5 (2A)
/TX_EN: Q2N3904.3 (C), R2_1K1.2, U1.1 (1OE)
/TX_O: R3_10K1.1, U1.2 (1A), U1.4 (2OE), U1.11 (4Y)
ArmsRelay: QArms.2 (B), U4.D28
Eyes: J_Eyes.1, U4.D32
GND: C1.2, C2.2, C3.2, C4.2, C5.2, J5V1.1, JGripper_L.3, JGripper_R.3, JMtr_Arm.3, JMtr_Arm#2.3, JMtr_Leg.3, JMtr_Leg#2.3, JMtr_Neck.3, JMtr_Torso.3, JPWR1.1, J_Eyes.3, Q2N3904.1 (E), QArms.3 (E), QLegs.3 (E), QNeckTorso.3 (E), U1.7 (GND), U2.2 (GND), U3.2 (GND), U4.GND_1 (GND), U4.GND_2 (GND), U4.GND_3 (GND)
HeadTorsoRelay: QNeckTorso.2 (B), U4.D33
LGripper: JGripper_L.1, U4.D40
LegsRelay: QLegs.2 (B), U4.D26
unnamed: D1.1 (K), D2.1 (K)
unnamed: D2.2 (A), K1.A2, QNeckTorso.1 (C)
unnamed: D3.2 (A), K1.NO
unnamed: D3.1 (K), JMtr_Neck.2, JMtr_Torso.2
unnamed: D4.1 (K), D5.1 (K)
unnamed: D5.2 (A), K2.A2, QArms.1 (C)
unnamed: D6.2 (A), K2.NO
unnamed: C2.1, C4.1, D6.1 (K), JMtr_Arm.2, JMtr_Arm#2.2, U2.1 (IN), U3.1 (IN)
unnamed: D7.1 (K), D8.1 (K)
unnamed: D8.2 (A), K3.A2, QLegs.1 (C)
unnamed: D9.2 (A), K3.NO
unnamed: D9.1 (K), JMtr_Leg.2, JMtr_Leg#2.2
unnamed: C5.1, JGripper_L.2, U3.3 (OUT)
unnamed: C3.1, JGripper_R.2, U2.3 (OUT)
unnamed: Q2N3904.2 (B), R3_10K1.2
unnamed: U4.3V3_1 (3V3), U4.3V3_2 (3V3)
unnamed: U4.VIN_1 (VIN), U4.VIN_2 (VIN)
RGripper: JGripper_R.1, U4.D34
RX1: U1.6 (2Y), U4.D19
TX1: U1.12 (4A), U4.D18
VCC: R1_1K1.1, R2_1K1.1, U1.13 (4OE), U1.14 (VCC), U4.5V_1 (5V), U4.5V_2 (5V), U4.5V_3 (5V)
