Mitokongdrya/SAMI_Presentation/hardware/Electrical/SensorArduinoHat/SensorArduinoHat.kicad_pcb

## KiCad design hardware/Electrical/SensorArduinoHat/SensorArduinoHat.kicad_pcb (2026-03-08)

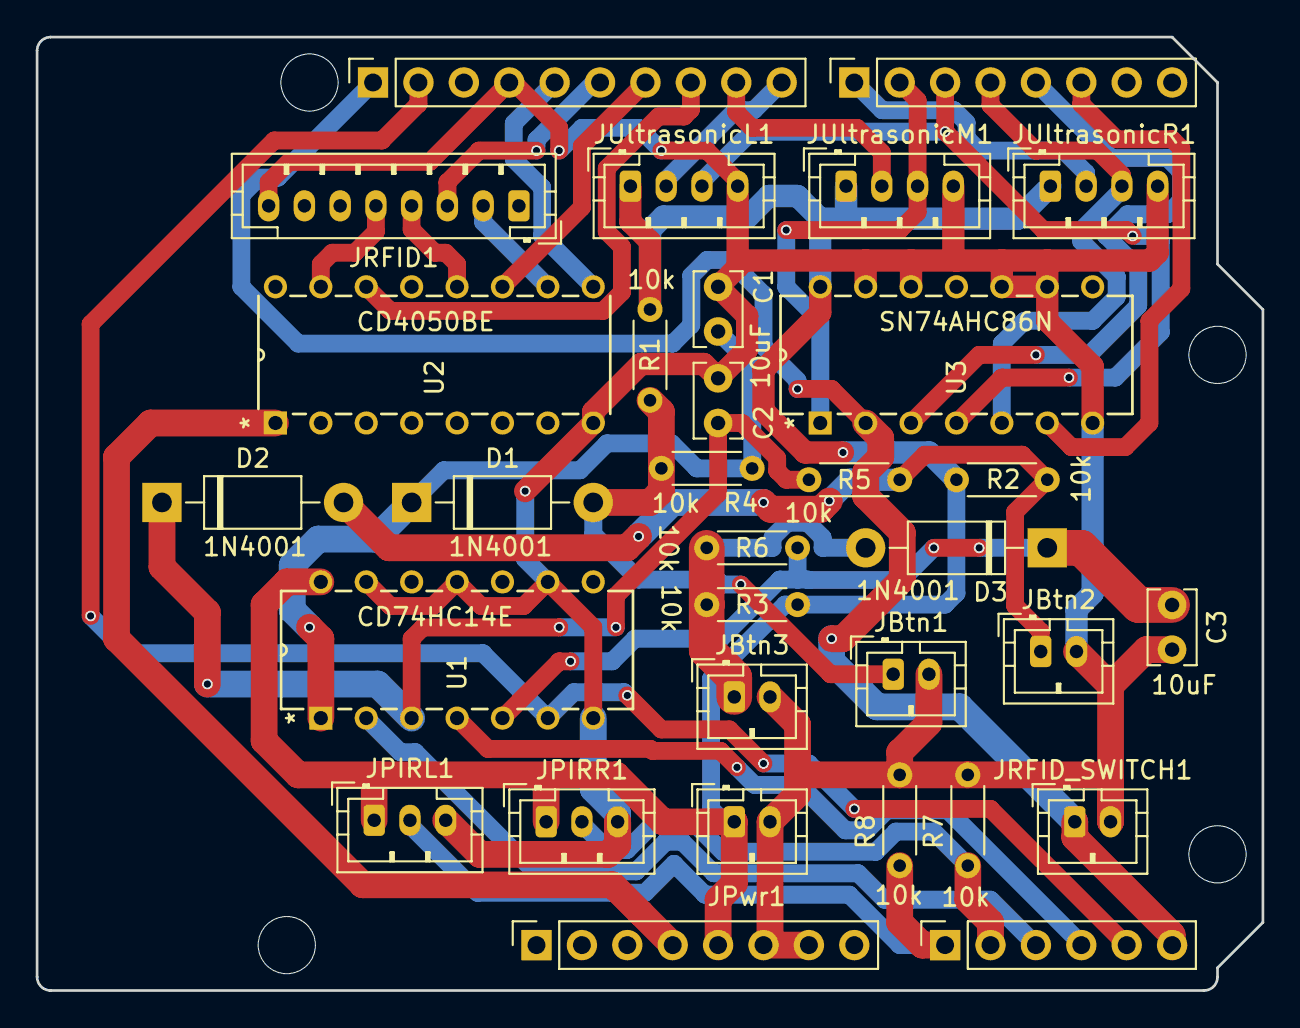
[picture p115: board SensorArduinoHat.kicad_pcb from above]

Board: 2 copper layers, 68.6 x 53.3 mm, 36 parts (0 on the bottom side), 30 nets.

Parts:
C1, C2, C3: 10uF; C_Rect_L4.0mm_W2.5mm_P2.50mm
D1, D2, D3: 1N4001; D_DO-41_SOD81_P10.16mm_Horizontal
J1: Power; PinSocket_1x08_P2.54mm_Vertical
J2: Digital/PWM; PinSocket_1x10_P2.54mm_Vertical
J3: Analog; PinSocket_1x06_P2.54mm_Vertical
J4: Digital/PWM; PinSocket_1x08_P2.54mm_Vertical
JBtn1, JBtn2, JBtn3: Conn_01x02; JST_PH_B2B-PH-K_1x02_P2.00mm_Vertical
JPIRL1: Conn_01x03; JST_PH_B3B-PH-K_1x03_P2.00mm_Vertical
JPIRR1: Conn_01x03; JST_PH_B3B-PH-K_1x03_P2.00mm_Vertical
JPwr1: Conn_01x02; JST_PH_B2B-PH-K_1x02_P2.00mm_Vertical
JRFID1: Conn_01x08; JST_PH_B8B-PH-K_1x08_P2.00mm_Vertical
JRFID_SWITCH1: Conn_01x02; JST_PH_B2B-PH-K_1x02_P2.00mm_Vertical
JUltrasonicL1: Conn_01x04; JST_PH_B4B-PH-K_1x04_P2.00mm_Vertical
JUltrasonicM1: Conn_01x04; JST_PH_B4B-PH-K_1x04_P2.00mm_Vertical
JUltrasonicR1: Conn_01x04; JST_PH_B4B-PH-K_1x04_P2.00mm_Vertical
MH1, MH2, MH3, MH4: MountingHole_3.2mm
R1, R2, R3, R4, R5, R6, R7, R8: 10k; R_Axial_DIN0204_L3.6mm_D1.6mm_P5.08mm_Horizontal
U1: CD74HC14E; N14
U2: CD4050BE; N16
U3: SN74AHC86N; N14

Connections:
5V: J1.5, JPIRL1.1, JPIRR1.1, JPwr1.1, JUltrasonicL1.1, JUltrasonicM1.1, JUltrasonicR1.1, R1.1, R2.1, R3.1, U1.14 (VCC), U3.14 (VCC)
+3V3: J1.4, U2.1 (VCC)
/2: J4.6, U3.6 (2Y)
/4: J4.4, JUltrasonicR1.3, U3.5 (2B)
/7: J4.1, JUltrasonicR1.2
/8: J2.10, JUltrasonicL1.2
/12: J2.6, JRFID1.3
/13: J2.5, U2.9 (D)
/*3: J4.5, U3.3 (1Y)
/*5: J4.3, JUltrasonicL1.3, U3.4 (2A)
/*6: J4.2, JUltrasonicM1.3, U3.1 (1A)
/*9: J2.9, JUltrasonicM1.2
/*10: J2.8, U2.14 (F)
/*11: J2.7, U2.11 (E)
/A0: J3.1, JPIRL1.2, R8.1
/A1: J3.2, JPIRR1.2, R7.1
/A2: J3.3, U1.2 (1Y)
/A3: J3.4, U1.4 (2Y)
/BtnPin3: J2.2, J3.5, U1.6 (3Y)
/MOSI: JRFID1.4, U2.12 (K=E)
/RFID Card Trigger: J2.1, J3.6, JRFID_SWITCH1.1, U3.2 (1B)
/SCK: JRFID1.2, U2.10 (J=D)
/SSEL: JRFID1.5, U2.15 (L=F)
GND: C1.2, C2.2, C3.2, J1.6, J1.7, J2.4, JBtn1.2, JBtn2.2, JBtn3.2, JPIRL1.3, JPIRR1.3, JPwr1.2, JRFID1.8, JRFID_SWITCH1.2, JUltrasonicL1.4, JUltrasonicM1.4, JUltrasonicR1.4, R7.2, R8.2, U1.7 (GND), U1.9 (4A), U1.11 (5A), U1.13 (6A), U2.8 (VSS), U3.7 (GND), U3.9 (3A), U3.10 (3B), U3.12 (4A), U3.13 (4B)
unnamed: D1.2 (A), JBtn1.1, R1.2, R4.2
unnamed: C1.1, D1.1 (K), R4.1, U1.1 (1A)
unnamed: D2.2 (A), JBtn2.1, R2.2, R5.2
unnamed: C2.1, D2.1 (K), R5.1, U1.3 (2A)
unnamed: D3.2 (A), JBtn3.1, R3.2, R6.2
unnamed: C3.1, D3.1 (K), R6.1, U1.5 (3A)
