Mitokongdrya/SAMI_Presentation/Arduino/SAMISensors/SAMISensors.ino

#include "globalVariables.h"
#include "Communication.h"
#include "ultrasonic.h"
#include "pir.h"
#include "button.h"
#include "rfid.h"

//int buttonStateY = 0; //variable for reading pushbutton
//int buttonStateN = 0; //variable for reading pushbutton
//float average = 0;               // The average of the readings.
//bool filled = false;             // Flag to check if readings array is initially filled.

////middle PIR
//int motion =0; //1 = motion detected; 0 = motion ended
//int motionStatus = 0; // Current PIR status 1 = motion detected 0 = motion ended
//int val = 0; //variable for reading the pin status
//int pirState = LOW; //start assuming no motion
//
////Right PIR
//int motionR =0; //1 = motion detected; 0 = motion ended
//int motionStatusR = 0; // Current PIR status 1 = motion detected 0 = motion ended
//int valR = 0; //variable for reading the pin status
//int pirStateR = LOW; //start assuming no motion
//
////Left PIR
//int motionL =0; //1 = motion detected; 0 = motion ended
//int motionStatusL = 0; // Current PIR status 1 = motion detected 0 = motion ended
//int valL = 0; //variable for reading the pin status
//int pirStateL = LOW; //start assuming no motion

//General detection variables
bool detected = false; //detection from eiher Left or Right PIR
bool center = false; //detection from both Left and Right PIR

unsigned long last_ultrasonic_check_ms = 0;
bool object_detected = false;
bool object_gone = false;

bool PERSON_PRESENT = false; //Global Person is Present

void setup() {
  // Ultrasonic setup
//  // Map pins 0-6 as input, and pin 7 as output, NOT SAFE, could accidentally fuck up your rx/tx
//  DDRD = B10000000;
//  // Map pins 8, 9, 10, and 13 to outputs, and the rest to inputs. bits 6 & 7 map to the crystal pins and are not usable
//  DDRB = B00100111;
   
  pinMode(TRIG_PINR, OUTPUT);
  pinMode(TRIG_PINL, OUTPUT);
  pinMode(TRIG_PINM, OUTPUT);
  digitalWrite(TRIG_PINR, LOW);
  digitalWrite(TRIG_PINL, LOW);
  digitalWrite(TRIG_PINM, LOW);
  pinMode(ECHO_PINR, INPUT);
  pinMode(ECHO_PINL, INPUT);
  pinMode(ECHO_PINM, INPUT);

  pinMode(ECHO_INTERR1, INPUT);
  pinMode(ECHO_INTERR2, INPUT);
  
  //pinMode(BUZZER_PIN, OUTPUT);
  //digitalWrite(BUZZER_PIN, LOW);
  //pinMode(PIR_PIN, INPUT); // Declare sensor as input
  pinMode(PIR_PINR, INPUT); // Declare sensor as input Right PIR
  pinMode(PIR_PINL, INPUT); // Declare sensor as input Left PIR

  initBtns();
//  pinMode(PUSHB_1, INPUT); // Initialize pushbutton 1
//  pinMode(PUSHB_2, INPUT); // Initialize pushbutton 2

  //initializeReadings();
  Serial.begin(115200);

  // RFID Setup
  pinMode(RFID_TRIG, INPUT_PULLUP);
  haveRFIDReader = initializeRFIDReader();
  
  // Then start our first ultrasonic ping
  // this one handles one of our echos and our rfid reader
  attachInterrupt(digitalPinToInterrupt(ECHO_INTERR2),
                  echoRFIDPinInterrupt,
                  CHANGE);
  // this one handles our other two echos
  attachInterrupt(digitalPinToInterrupt(ECHO_INTERR1),
                  echoPinInterrupt,
                  CHANGE);
  startUltrasonicPing(0);
  startUltrasonicPing(1);
  startUltrasonicPing(2);
  
  // Stabilization delay for the PIRs, which have a bunch of ping wiggles during initial power on
  #if (defined(DEBUG) && DEBUG) || (defined(DEBUG_LOGIC) && DEBUG_LOGIC) 
    Serial.println("Stabilizing sensor...");
  #endif
  //delay(45000);  // 45 seconds stabilization time
  delay(20000);
  #if (defined(DEBUG) && DEBUG) || (defined(DEBUG_LOGIC) && DEBUG_LOGIC) 
    Serial.println("Sensor stabilized.");
  #endif

  
}

void loop() {
  unsigned long current_time = millis();

  // Update all our PIR sensors
  readAllPIRs();
  // Update all our ultrasonic sensor calls
  updateAllUltrasonic();

  // Logic handling go here

  // If PIR sees motion and...
    // ultrasonic is 1 => a person has entered range
    // ultrasonic is 0 => a person is not moving in either direction
    // ultrasonic is 2 => a person is approaching the system (crossing in front of the system)
    // ultrasonic is 3 => a person is moving away from the system
    // ultrasonic is anything else => then we don't care about the movement

  //
  
  // if we have motion on the left, and the left ultrasonic says someone has entered it's range
  if (motionStatusL && ultraStatus[1] == 1) {
    // send a serial message about a new person having appeared on the left
    sendPirDataL(1);
  }
  
  // if we have motion on the right, and the right ultrasonic says someone has entered it's range
  if (motionStatusR && ultraStatus[0] == 1) {
    // send a serial message about a new person having appeared on the left
    sendPirDataR(1);
  }
  // something with checking the center too, I guess...

  

  // function checks the state of all buttons and sends any button messages if a button has been pressed
  checkBtns();

  // Check if we need to parse a change with the rfid card
  checkRFIDCard();


//  
//
//  // LOGIC INCOMPLETE
//  // if we haven't currently detected anything
//  if(!detected) {
//    // if someone in front/ or both sensors
//    if ((motionStatusL && motionStatusR) || objectInRange) {
//      detected = true;
//      sendPirData(1);
//      if (objectInRange) {
//        center = true;
//        #if (defined(DEBUG) && DEBUG) || (defined(DEBUG_LOGIC) && DEBUG_LOGIC) 
//          Serial.println("Someone at center");
//        #endif
//      }
//    }
//    // If someone approaches from the left
//    else if (motionStatusL) {
//      detected = true;
//      sendPirDataL(1);
//      #if (defined(DEBUG) && DEBUG) || (defined(DEBUG_LOGIC) && DEBUG_LOGIC) 
//        Serial.println("Someone from left");
//      #endif
//    }
//    // If someone approaches from the right
//    else if (motionStatusR) {
//      detected = true;
//      sendPirDataR(1);
//      #if (defined(DEBUG) && DEBUG) || (defined(DEBUG_LOGIC) && DEBUG_LOGIC) 
//          Serial.println("Someone from right");
//        #endif
//    }
//    
//  }

//  if (distanceChange == 1) {
//    // If we got closer...
//  }
//  else if (distanceChange == 2) {
//    // If we got further...
//    if (!objectInRange) {
//      center = false;
//      distanceChange = 0;
//    }
//  }

  

  // If we detect motion from left or right, and have nothing detected in the center...
//  if ((motionStatusL || motionStatusR) && !detected && !center) {
//    // Then we have detected a person passing
//    detected = true;
//    // and we need to send a message that we detected something
//    sendPirData(1);
//  }
//  // If something has gotten closer, and we are not centered
//  else if (distanceChange == 1 && !center) {
//    // Then something has come up in the front
//    detected = true;
//    center = true;
//    sendPirData(1);
//    // reset this since we've acknowledged there was a change
//    distanceChange = 0;
//  }
//  else if ((motionStatusL || motionStatusR) && distanceChange == 2 && detected && center) {
//    // Ahhh??? Maybe a person is leaving? Still detected but leaving
//    center = false;
//    distanceChange = 0;
//  }
//  else if (!motionStatusL && !motionStatusR && distanceChange == 0 && !center && detected) {
//    // then probably they've left
//    detected = false;
//    sendPirData(0);
//  }


  // Original motion detect code

   // Only check PIR sensor if no object is detected by the ultrasonic sensor
//    // PIR Sensor
//    pir(PIR_PIN);
//    // PIR Sensor Right
//    pirR(PIR_PINR);
//    // PIR Sensor Left
//    pirL(PIR_PINL);

//// If motion detected by either sensor, no previous detection, and not centered
//if ((motionStatusL || motionStatusR || motionStatus) && !detected && !center) {
//    sendPirData(1);
//    //Serial.print("Time: ");
//    //Serial.print(current_time);
//    Serial.println(" ms - Person DETECTED!");
//    detected = true; // Set detected to true
//    center = false;  // Ensure center is false
//} 
//// If motion detected by both sensors, previously detected, but not centered
//else if (((motionStatusL && motionStatusR && motionStatus)|| (motionStatusL && motionStatus)|| (motionStatusR && motionStatus) ||(motionStatusL && motionStatusR)) && detected && !center) {
//    //Serial.print("Time: ");
//    //Serial.print(current_time);
//    Serial.println(" ms - Person has ENTERED the CENTER");
//    sendPirDataM(1); //send 1 when entering center
//    detected = true; // Ensure detected remains true
//    center = true;   // Set center to true
//} 
//// If motion detected by only one sensor, previously detected and centered
//else if (((motionStatusL && !motionStatusR && !motionStatus) || (!motionStatusL && motionStatusR && !motionStatus)|| (!motionStatusL && !motionStatusR && motionStatus)) && detected && center) {
//    //Serial.print("Time: ");
//    //Serial.print(current_time);
//    sendPirDataM(0); //send 0 when entering center
//    Serial.println(" ms - Person is LEAVING the CENTER");
//    detected = true; // Ensure detected remains true
//    center = false;  // Set center to false
//} 
//// If no motion detected by both sensors, previously detected but not centered
//else if (!motionStatusL && !motionStatusR && !motionStatus && detected && !center) {
//    sendPirData(0);
//    //Serial.print("Time: ");
//    //Serial.print(current_time);
//    Serial.println(" ms - Person has fully LEFT");
//    detected = false; // Set detected to false
//    center = false;   // Ensure center remains false
//}

  
    
//  //read the state of the pushbutton value:
//  buttonStateY = pushButton1(PUSHB_1);
//// //send the message only if the button has been pressed
// if (buttonStateY == 1){
//  sendPushButtonData(0);
// }
////  //read the state of the pushbutton value:
//  buttonStateN = pushButton2(PUSHB_2);
//
////send the message only if the button has been pressed
//  if (buttonStateN == 1){
//  sendPushButtonData(1);
// }  
delay(100);
}
