Mitokongdrya/SAMI_Presentation/(commit log)

2026-03-08 Initial SAMI capstone integration
    [JamieMotorControl.kicad_pcb, JamieMotorControl.kicad_sch, N0014A.stp, SAMIMotorControlBoardDigiKey.csv, SAMIPartList.xlsx, SAMIRobotDigiKey.csv, SensorArduinoHat.kicad_pcb, SensorArduinoHat.kicad_sch]
2026-03-09 Add button icons for data sub-pages
2026-03-09 Add showcase trivia
    [showcase_trivia.csv]
2026-03-11 Switched hardcoded variables to style variables
2026-03-13 Updated requirements to switch from pyqt5 to pyqt6
2026-03-15 Restructure trivia & icons into folders & subfolders
    [showcase_trivia.csv, trivia_questions.csv]
2026-03-15 Restructure README to put current documentation first
