Mitokongdrya/SAMI_Presentation/docs/res/LeftFoot_Leg_Back.jpeg

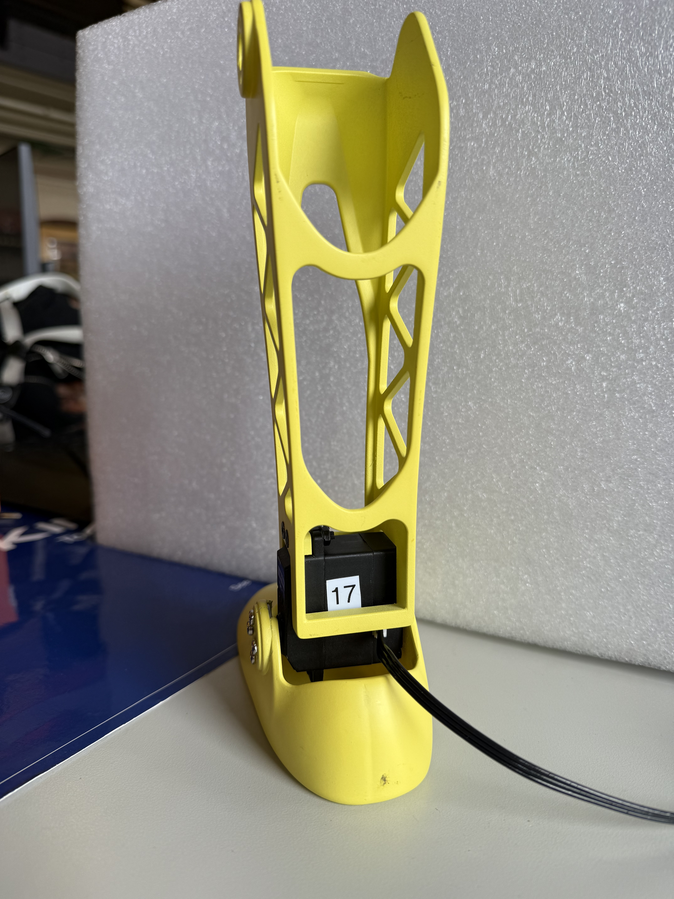
docs/res/LeftFoot_Leg_Back.jpeg
