Mitokongdrya/SAMI_Presentation/docs/res/LeftFoot_Leg_Side.jpeg

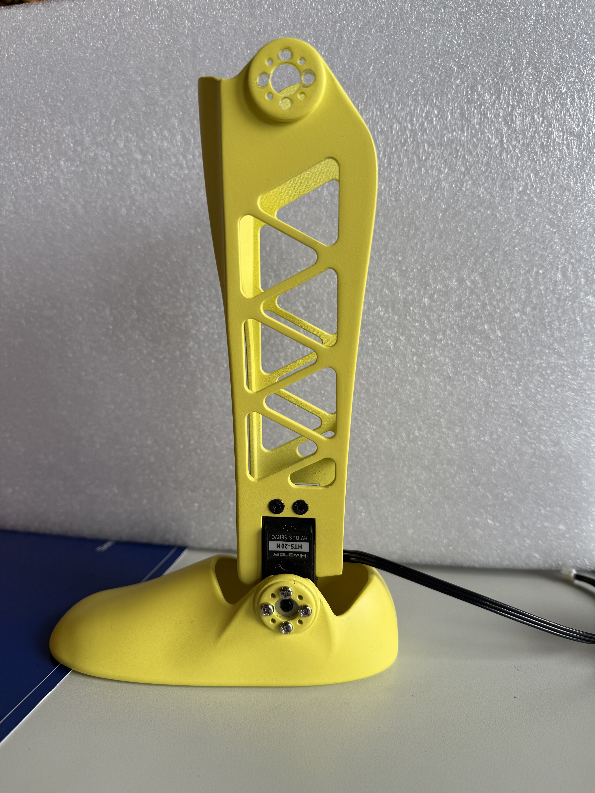
docs/res/LeftFoot_Leg_Side.jpeg
