Mitokongdrya/SAMI_Presentation/docs/res/LeftLeg_Back.jpeg

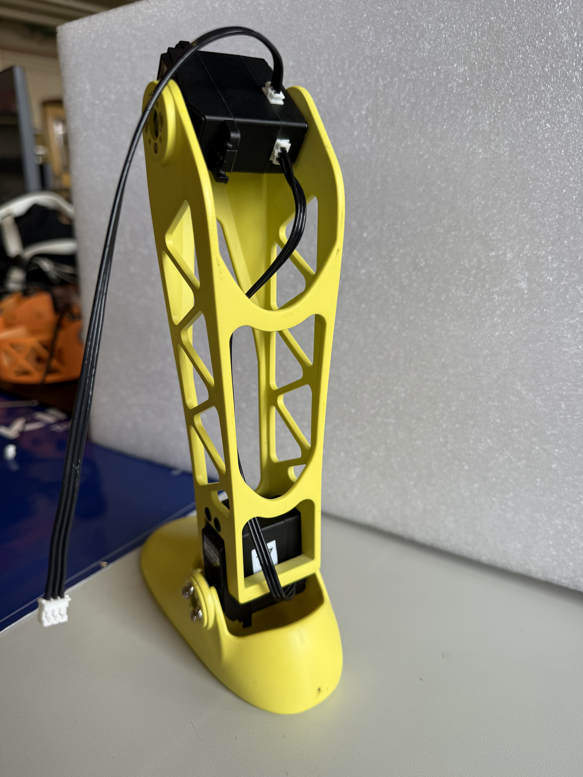
docs/res/LeftLeg_Back.jpeg
