Mitokongdrya/SAMI_Presentation/docs/res/Neck_Front.jpeg

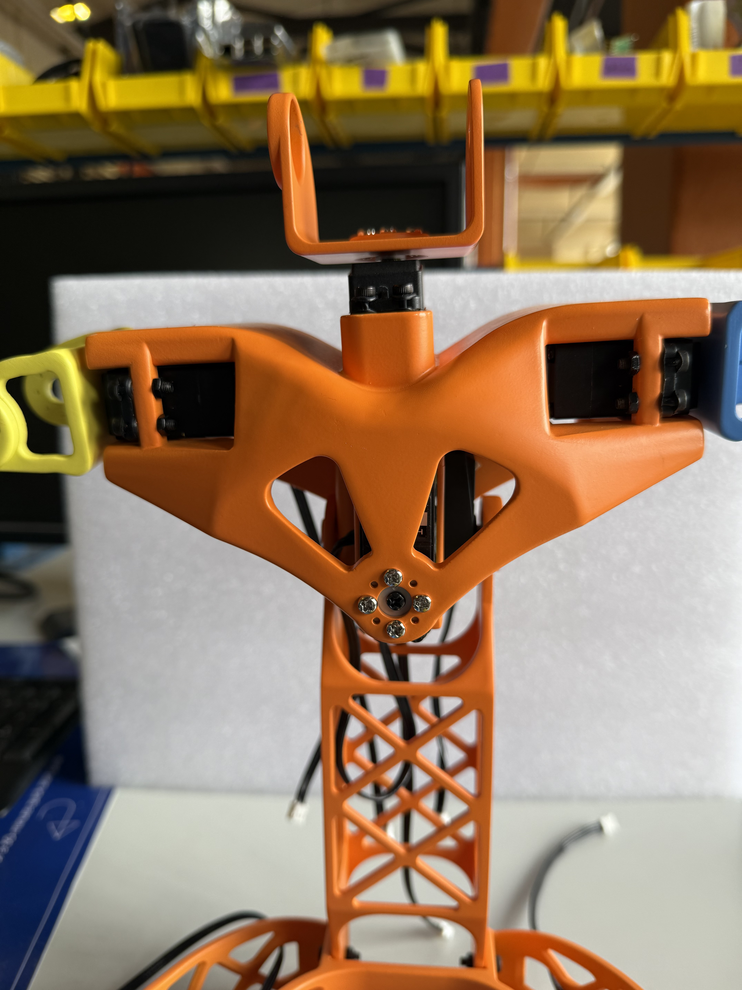
docs/res/Neck_Front.jpeg
