Mitokongdrya/SAMI_Presentation/docs/res/Biceps_Back.jpeg

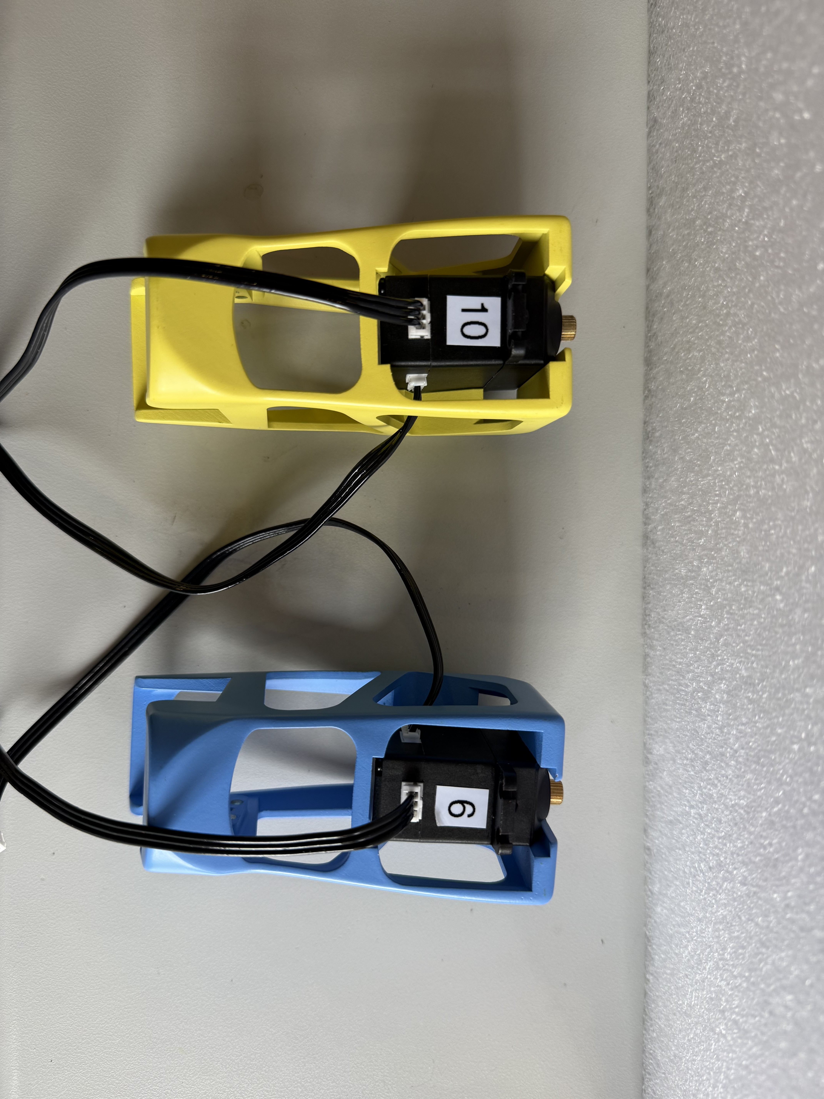
[picture p28: docs/res/Biceps_Back.jpeg]
docs/res/Biceps_Back.jpeg
