Mitokongdrya/SAMI_Presentation/docs/res/Bicep_Shoulder_Front.jpeg

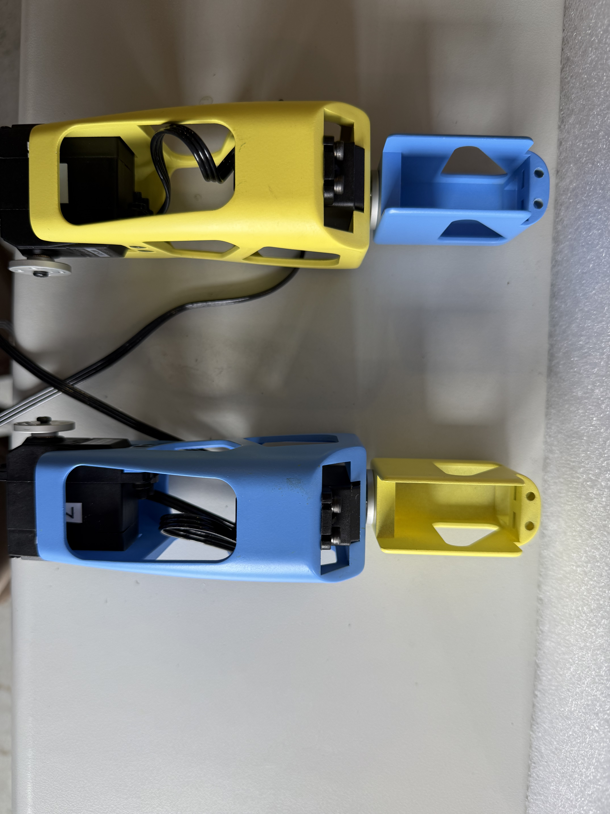
[picture p33: docs/res/Bicep_Shoulder_Front.jpeg]
docs/res/Bicep_Shoulder_Front.jpeg
