Mitokongdrya/SAMI_Presentation/docs/res/ArduinoCircuit_Front.jpeg

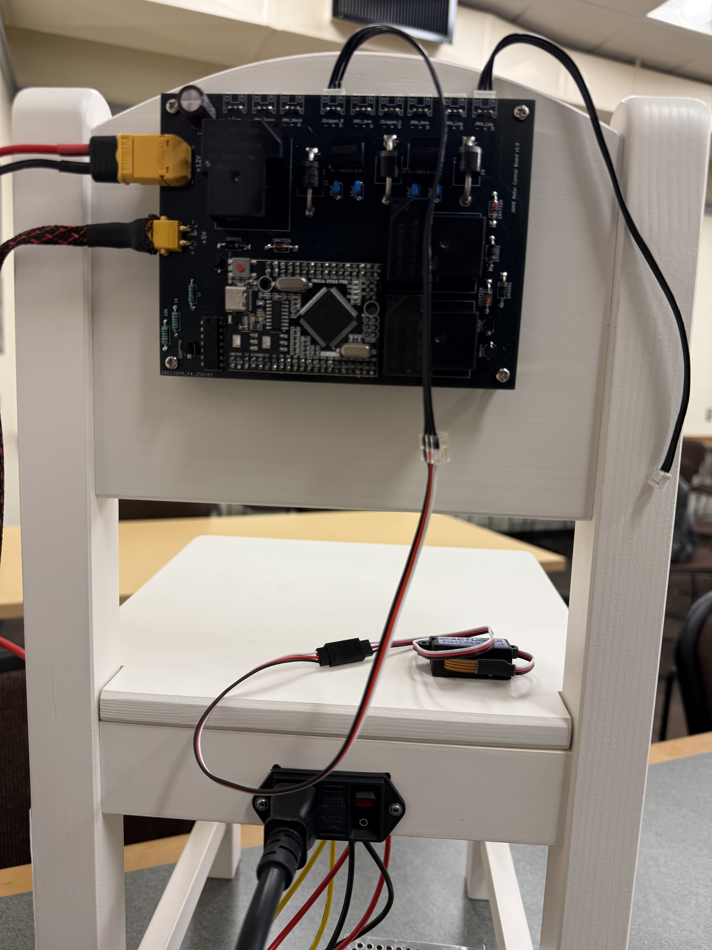
[picture p42: docs/res/ArduinoCircuit_Front.jpeg]
docs/res/ArduinoCircuit_Front.jpeg
