Mitokongdrya/SAMI_Presentation/docs/res/FullLegAssembly_Front.jpeg

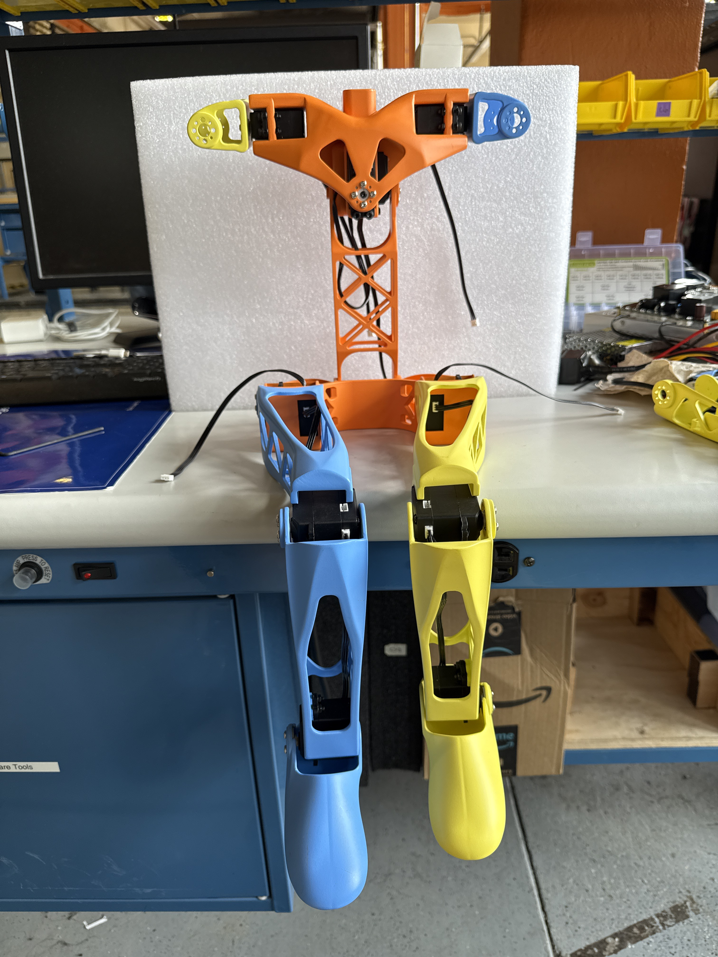
[picture p73: docs/res/FullLegAssembly_Front.jpeg]
docs/res/FullLegAssembly_Front.jpeg
