Mitokongdrya/SAMI_Presentation/docs/res/Neck_NeckConnector_Side.jpeg

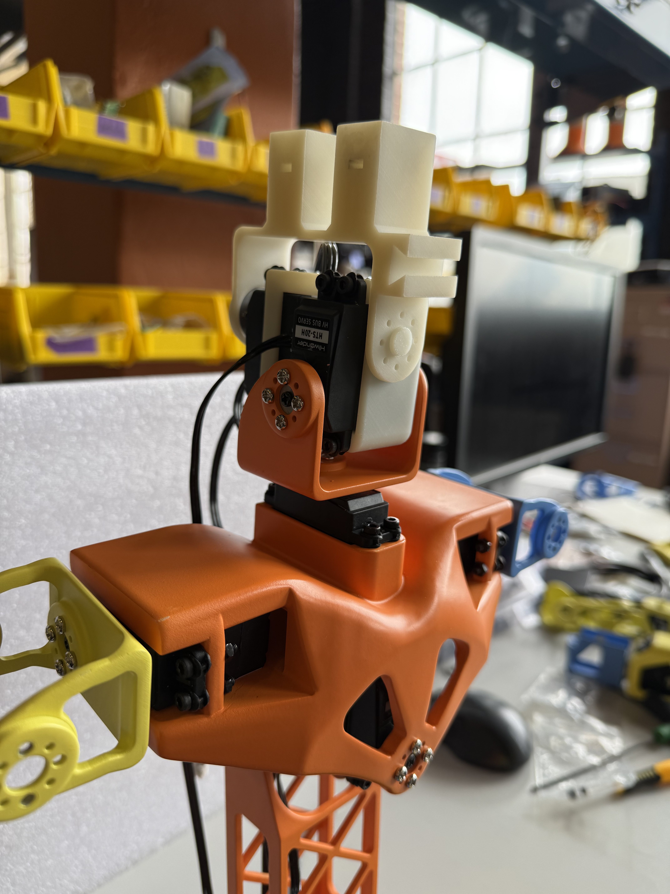
[picture p100: docs/res/Neck_NeckConnector_Side.jpeg]
docs/res/Neck_NeckConnector_Side.jpeg
