Mitokongdrya/SAMI_Presentation/docs/res/ArmAssembly_Side.jpeg

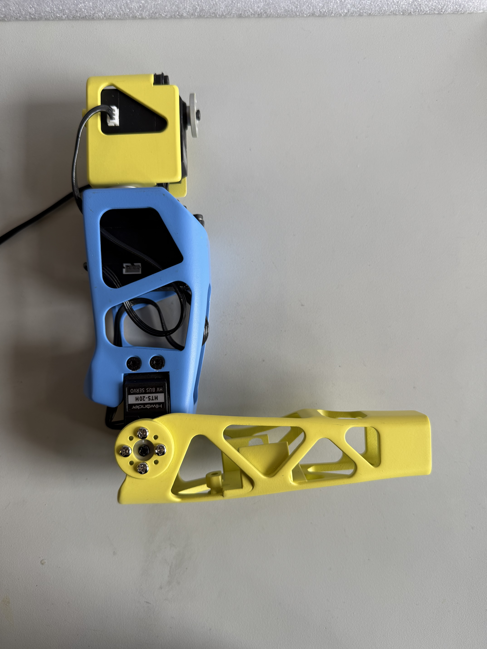
docs/res/ArmAssembly_Side.jpeg
